c20d-us/Gnimu/branding/wordmark/gnimu-wordmark-white-on-navy.png

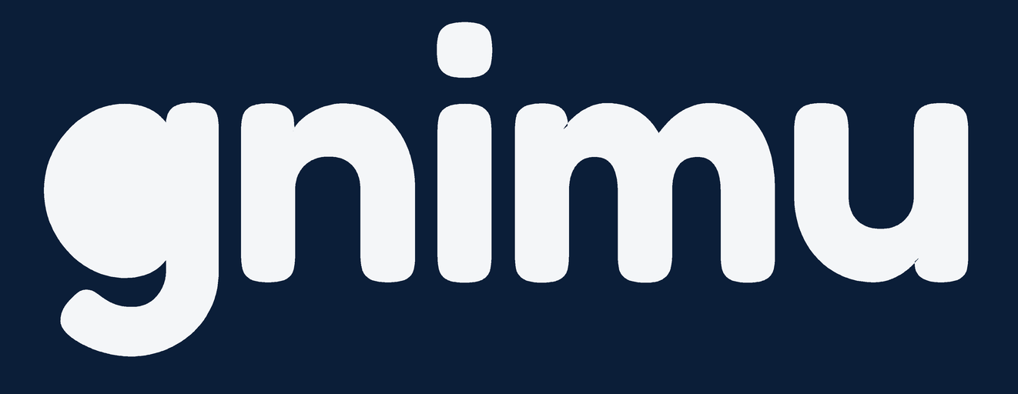
branding/wordmark/gnimu-wordmark-white-on-navy.png
