c20d-us/Gnimu/docs/building.md

# Building and flashing

The firmware is one Arduino sketch, [`code/Gnimu/`](../code/Gnimu/), that builds for both supported boards. You can build it in the Arduino IDE or from the command line with `arduino-cli`; both use the same toolchain and produce the same firmware.

For the hardware side of a build (parts, wiring, photos), see the guide for your board: [ESP32](build-esp32.md) or [XIAO nRF52840](build-nrf52840.md).

---

## What you need

| | ESP32 | XIAO nRF52840 |
|---|---|---|
| Board package | **esp32** by Espressif Systems | **Seeed nRF52 Boards** |
| Board to select | **ESP32 Dev Module** | **Seeed XIAO nRF52840 Sense** |
| Libraries | SparkFun u-blox GNSS v3 | SparkFun u-blox GNSS v3, Seeed Arduino LSM6DS3 |

BLE support comes with each board package; there is no BLE library to install.

These are the versions the firmware is built and tested against. Newer ones will probably work, but if something breaks after an update, come back to these:

| Component | Version |
|---|---|
| esp32 board package | 3.3.12 |
| Seeed nRF52 Boards | 1.1.13 |
| SparkFun u-blox GNSS v3 | 3.1.15 |
| Seeed Arduino LSM6DS3 | 2.0.7 |

> [!IMPORTANT]
> **Use "Seeed nRF52 Boards", not "Seeed nRF52 mbed-enabled Boards".** The mbed-enabled package lacks the Bluefruit BLE stack this firmware uses.

---

## Arduino IDE

1. Install the [Arduino IDE](https://www.arduino.cc/en/software) (2.x).
2. For the XIAO nRF52840, add this URL under **Settings → Additional boards manager URLs**:
   ```
   https://files.seeedstudio.com/arduino/package_seeeduino_boards_index.json
   ```
3. Install the board package for your board from the **Boards Manager**, and the libraries from the **Library Manager** (see the table above).
4. Open [`code/Gnimu/Gnimu.ino`](../code/Gnimu/Gnimu.ino).
5. Select your board and its serial port.
6. Click **Upload**.
7. Open the **Serial Monitor** at **115200 baud** to watch the boot log. See [Console and diagnostics](console.md) for what it shows.

There is nothing you have to edit before the first build. The settings you might want to change later are in [`Config.h`](../code/Gnimu/Config.h), which appears as a tab next to the sketch; see [Configuration](configuration.md).

If an upload to the XIAO can't reset the board into its bootloader, **double-tap the reset button on the XIAO** to force it, then upload again.

> [!IMPORTANT]
> If you are building on an Apple Silicon Mac, you can use the native Arduino IDE but you **must** have Rosetta installed in order to compile. Without Rosetta installed you will get a compilation error.

> [!IMPORTANT]
> **macOS build gotcha (XIAO nRF52840):** The Seeed nRF52 core's `platform.txt` invokes bare `python` for its UF2 step, but modern macOS only ships `python3`, so compiling fails with `exec: "python": executable file not found in $PATH`.
>
> **Fix:** with Homebrew's Python installed (`brew install python`), put its unversioned `python` on your `PATH` by adding this line to your zsh startup file, such as `~/.zshrc`:
> ```bash
> export PATH="$(brew --prefix python)/libexec/bin:$PATH"
> ```
> Editing the core's `platform.txt` also works, but the edit reverts on every core reinstall or update. [`scripts/setup.sh`](../scripts/setup.sh) checks that `python` resolves.

### The build stamp

Every boot prints a `BUILD` line with the firmware's version, git revision, and build time. Those values are filled in by the build script described below, and reach a device when it is [flashed from the command line](#flashing-from-the-command-line). The Arduino IDE doesn't run that script, so an IDE build reports placeholders instead:

```
BUILD,version=0.0.0-dev,revision=IDE-UNSTAMPED,dirty=unknown,utc=unknown,target=...
```

That is expected, and the firmware is otherwise identical.

---

## Command line

[`scripts/build.sh`](../scripts/build.sh) builds the firmware with `arduino-cli`:

```bash
scripts/build.sh            # both boards
scripts/build.sh esp32      # one board
scripts/build.sh nrf52840
scripts/build.sh nrf52840 --hardware classic   # Classic nRF52840 wiring and IMU axes
scripts/build.sh --matrix                      # every board and profile combination
```

`--hardware <name>` and `--protocol <name>` choose the build's [profiles](configuration.md#build-variants): small header files that hold the pins, the IMU mounting and the protocol. Hardware profiles belong to a board, so name the board with `--hardware`. Left out, the build uses the defaults. The choice is passed to the compiler as a flag, so no file is modified, and a build from a clean tagged commit reports `dirty=0` whichever profile you pick.

The script:

- compiles from clean with all warnings on, and **fails if any warning comes from the project's own sources** (warnings from board packages and libraries are shown but don't fail the build);
- stamps the version, git revision, and build time into the firmware;
- writes the finished firmware to `build/esp32/` or `build/nrf52840/`, with the profile names appended when you give them (`build/nrf52840-classic/`), so builds of one commit don't overwrite each other.

It finds `arduino-cli` on your `PATH`, or uses the copy bundled with the Arduino IDE on macOS, or whatever `ARDUINO_CLI` points to. It uses its own build folder, so it can run alongside an IDE build without either disturbing the other.

### Setting up a fresh machine

On a clean Mac, with no Arduino IDE:

```bash
xcode-select --install                                  # git, g++, python3
softwareupdate --install-rosetta --agree-to-license     # Apple Silicon only
brew install arduino-cli python
```

Add the `python` line from the [macOS build gotcha](#arduino-ide) to your zsh startup file (such as `~/.zshrc`), then run:

```bash
scripts/setup.sh
```

[`scripts/setup.sh`](../scripts/setup.sh) checks those tools, then installs the board packages and libraries at the tested versions. It is safe to run again. [`arduino-cli.yaml`](../arduino-cli.yaml), in the repository root, carries the Seeed boards manager URL. If you already installed everything through the Arduino IDE, `arduino-cli` shares those installs and there is nothing more to do.

### Flashing from the command line

[`scripts/flash.sh`](../scripts/flash.sh) uploads what `build.sh` last built for a board. It doesn't build anything itself, so what reaches the device is exactly the firmware in `build/<board>/`, stamp included.

```bash
scripts/build.sh nrf52840
scripts/flash.sh nrf52840
```

`flash.sh` takes the same `--hardware` and `--protocol` options as `build.sh` and picks the matching build directory, so pass the ones you built with. Add `--build` to build first with those options and flash the result in one step; if the build fails, nothing is flashed:

```bash
scripts/flash.sh nrf52840 --build --hardware classic
```

Add `--monitor` to open the serial console on the same port once the upload finishes, so you see the [boot log](console.md#the-boot-log) from the first line. Press Ctrl-C to quit:

```bash
scripts/flash.sh nrf52840 --monitor
```

**XIAO nRF52840.** With one XIAO connected, the script finds its port by itself. The upload resets the board into its bootloader, as it does from the IDE; if that fails, double-tap the XIAO's reset button and run the script again.

**ESP32.** A dev board's USB-serial chip doesn't say what board it's on, so name the port:

```bash
scripts/build.sh esp32
scripts/flash.sh esp32 /dev/cu.usbserial-0001
```

To see which ports are connected:

```bash
arduino-cli board list
```

On macOS they look like `/dev/cu.usbmodem1101` or `/dev/cu.usbserial-0001`; on Linux, `/dev/ttyACM0` or `/dev/ttyUSB0`; on Windows, `COM3`.

Close the IDE's Serial Monitor, or any other serial terminal on that port, before flashing. An open terminal can block the upload.

A device flashed this way reports a stamped `BUILD` line, at boot and whenever you type `V`:

```
BUILD,version=2.0.0-rc1,revision=7f7efe5f4d6a,dirty=0,utc=2026-10-11T17:27:43Z,target=esp32
```

| Field | Meaning |
|---|---|
| `version` | The tag the firmware was built from. Between tags it is the nearest tag, the number of commits since it, and the commit, such as `2.0.0-rc1-3-g1a2b3c4`. |
| `revision` | The commit the firmware was built from. |
| `dirty` | `1` if the working tree had uncommitted changes when it was built, `0` if it was clean. |
| `utc` | When it was built. |

That line settles which firmware a device is running, which an IDE build's `IDE-UNSTAMPED` cannot. Which hardware profile and protocol it was built for follow in the `Config:` lines `V` prints (`hardware`, `IMU axes`, `BLE`).

The script is a thin wrapper. The command underneath is:

```bash
arduino-cli upload --config-file arduino-cli.yaml --fqbn <board> --port <port> --input-dir build/<board>
```

with `esp32:esp32:esp32` or `Seeeduino:nrf52:xiaonRF52840Sense` as the board.

---

## Host tests

The hardware-independent part of the firmware, [`code/Gnimu/src/core/`](../code/Gnimu/src/core/), has unit tests that run on your computer with no board attached:

```bash
tests/run.sh
```

It needs only `g++`. Each test is built and run twice: once plain, and once under AddressSanitizer and UndefinedBehaviorSanitizer, where the first finding fails the run.

The tests compile as C++11 on purpose. The Seeed nRF52 board package builds sketches as C++11, so anything newer in `core/` would fail the nRF52840 build; compiling the tests the same way catches it here first.

---

## Continuous integration

Every push and pull request runs the host tests and builds both boards with `scripts/build.sh`, at the versions listed above. The workflow is [`.github/workflows/ci.yml`](../.github/workflows/ci.yml).
