c20d-us/Gnimu/classic/src/Gnimu-nRF52840-OLED/config.h

// Gnimu - RaceBox Mini-compatible GNSS+IMU streaming telemetry
// Copyright (C) 2026 Chris Halstead
//
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
#pragma once

// This file has two top-level sections:
//   1. TUNABLES - values you should expect to change: thresholds, timing,
//      alphas, feature flags, per-build calibration, and wiring choices you
//      made yourself (i.e., which GPIO you routed a signal to).
//   2. SUPPORTING CONSTANTS - hardware descriptors that will break the
//      firmware if changed without also changing the physical part: pins/
//      addresses fixed by the board or chip, protocol UUIDs, and values
//      derived from other constants.
// Within each section, entries are grouped by subsystem (Device Identity,
// SAADC, IMU, GNSS, BLE, Battery, Power, State, LED, Logging, Protocol), in
// the same order in both sections. Every define is prefixed with the
// subsystem it belongs to, and every value that carries a unit is suffixed
// with it (_MS, _US, _MV, _V, _HZ, _G, _DPS, _DEG, _DBM, _OHM, _BITS, _PIN).

// Pull in Arduino.h for the board's pin/peripheral macros (D6, D7,
// PIN_LSM6DS3TR_C_POWER, ...). config.h uses these symbolic names instead of
// raw pin numbers, so it must see Arduino.h first.
#include <Arduino.h>

// ============================================================================
// ============================================================================
// SECTION 1: TUNABLES
// ============================================================================
// ============================================================================

// ----------------------------------------------------------------------------
// --- Device Identity ---
// ----------------------------------------------------------------------------

// Change DEVICE_ID to personalize your device.
// It is a STRING of exactly 10 digits - quote it, so leading zeros are kept
// (e.g. "0123456789"). Do NOT use a bare number: a leading zero would be read
// as an octal literal and an unquoted ID loses its leading zeros.
// First digit must be 0-3, so the value stays below 4000000000 - the RaceBox
// app will not connect to IDs of 4000000000 or higher. See compile-time
// validation at the bottom of this file.
#define DEVICE_ID "1000000003"

// Identifies which build this binary is, printed as the first line of the
// startup banner. Purely diagnostic - nothing branches on it.
#define GNIMU_VARIANT "nRF52840-OLED"

// ----------------------------------------------------------------------------
// --- IMU (onboard LSM6DS3TR-C) ---
// ----------------------------------------------------------------------------

#define IMU_SAMPLE_INTERVAL_MS 10 // default 100Hz filter/sample rate

// ImuAxis smoothing rates and transient thresholds. The deviation that a
// sample window's peak must exceed before it gets blended into the transmitted
// value instead of the plain EMA baseline.
//
// The ACCEL values are tuned from 13 autocross runs (2018 M2, RE-71RS) checked
// against the GNSS solution: longitudinal against d(speed)/dt, lateral against
// v * yaw-rate. The GYRO values are still placeholders - the logging app
// records no gyro channel, so nothing here has been tested against real data.
//
// The threshold must sit ABOVE the car's vibration floor. At the original 0.2g
// it sat below it: the blend fired on 50-100% of transmit windows, and since
// maxDeviation_ is a max over the window it can only push the output away from
// the baseline, never toward it. Logged lateral peaks ran up to +105% over the
// true value (2.57g against a real 1.16g) and correlation with the GNSS
// reference fell to 0.92.
//
// 1.5g is a HOLDING value for a mount known to be too springy, where the
// vibration floor alone drives |raw - smoothedValue_| to ~1.55g. No threshold
// below that separates vibration from genuine events, so the blend is
// deliberately parked out of reach and the output is the plain EMA baseline.
// Re-tune after the mount is stiffened: log the real floor, then set this to
// roughly 1.2x the observed peak deviation (~0.6-0.8g on a rigid mount) to
// bring the blend back for the impacts and kerb strikes it exists to catch.
//
// The two settings are NOT independent. A lower alpha makes the EMA baseline
// lag further, which INCREASES |raw - smoothedValue_| and so makes the blend
// fire MORE. Lowering the alpha without raising the threshold first makes the
// output worse, not smoother.
//
// The alpha also serves as the anti-alias filter for the 100Hz -> transmit-rate
// decimation, so it cannot be raised freely: mount resonance above the
// transmit Nyquist folds into the signal band, where no later filter can
// remove it. 0.09 puts the corner at ~1.5Hz, which measured best against the
// GNSS reference (0.99 correlation) while leaving real cornering amplitude
// intact - below ~0.06 it starts eating genuine signal.
#define IMU_ACCEL_ALPHA 0.09f // EMA smoothing: 1.0=raw, 0.1=heavy. ~1.5Hz
#define IMU_GYRO_ALPHA 0.09f  // EMA smoothing: 1.0=raw, 0.1=heavy. ~3.6Hz
#define IMU_ACCEL_TRANSIENT_THRESHOLD_G 99.0f    // 1.5g = ~14.7m/s^2
#define IMU_GYRO_TRANSIENT_THRESHOLD_DPS 9999.0f // 28.6deg/s = ~0.5rad/s

#define IMU_ACCEL_RANGE_G 4       // +/- g sensor range: one of 2, 4, 8, 16
#define IMU_GYRO_RANGE_DPS 500    // deg/s sensor range: 125,245,500,1000,2000
#define IMU_ACCEL_ODR_HZ 104      // output data rate; >= the 100Hz poll rate
#define IMU_GYRO_ODR_HZ 104       // output data rate; >= the 100Hz poll rate
#define IMU_ACCEL_BANDWIDTH_HZ 50 // anti-alias filter: one of 50, 100, 200, 400

// --- Runtime IMU trim (levelling + gyro de-bias) ---
// Learned while the vehicle is confirmed stationary, frozen while it moves.
// Corrects a slightly off-level mount and the gyro zero point without any
// per-board calibration step. Design record: docs/imu-trim-design.md.
//
// These are per-DESIGN values, not per-board: identical on every unit. Only
// IMU_GRAVITY_NATIVE and IMU_TRIM_GYRO_VAR_MAX differ between the nRF52840
// and ESP32 families, and only because their native units differ.

// 1 g expressed in this variant's native accel units. The trim module is
// otherwise unit-agnostic; this is the single magnitude it needs.
#define IMU_GRAVITY_NATIVE 1.0f // g on the LSM6DS3; 9.80665f (m/s^2) on ESP32

// How long every stillness criterion must hold CONTINUOUSLY before a window
// opens.
//
// Sensor noise is NOT what sets this: at ~90ug/sqrt(Hz) and 50Hz bandwidth,
// half a second of averaging lands under 0.1mg, two orders finer than anything
// relevant.
//
// Nor is it what keeps a sloped staging lane out of the calibration - locking
// after the first qualifying window does that, because the first stop of a
// session is the paddock. Selection happens by ORDERING, not by duration.
//
// What the length actually buys is a backstop for when that ordering does not
// hold: the device is switched on as the car leaves the paddock, so the first
// qualifying stop is a staging lane or a red light on a cambered road. 10s
// clears a rolling pause or a stop sign. It cannot fix the case properly -
// only powering the device on where it is parked does that.
#define IMU_TRIM_QUALIFY_MS 10000

// Averaging block length once the window is open. A long stop yields a steady
// run of blocks rather than re-serving the qualification delay between each.
#define IMU_TRIM_BLOCK_MS 1000

// Blocks averaged into the orientation before it LOCKS for the rest of the
// power cycle. 5 blocks = 5s of data on top of the qualification wait.
//
// Not a noise requirement - the gate already rejects any block containing a
// disturbance, and one block is far more than enough for precision. This is
// margin against a sub-threshold disturbance (someone leaning on the car)
// biasing a measurement that is never revisited.
#define IMU_TRIM_LOCK_BLOCKS 5

// GNSS ground speed below which we may be stationary.
#define IMU_TRIM_SPEED_MAX_MPS 0.5f

// |a| PLAUSIBILITY band, as a fraction of gravity - unit-free, hence no
// per-variant value.
//
// Deliberately WIDE, and deliberately not a tight "is |a| exactly 1 g" test.
// A tight band has the same circularity that made us gate the gyro on variance
// rather than magnitude: |a| at rest is contaminated by the chip's own zero-g
// bias, which is exactly what the trim exists to remove, so a tight band holds
// the gate shut against the very measurement that would fix it.
//
// That is not hypothetical. The MPU-6050 on the ESP32 build has -69 mg on Z;
// once its hand-measured offset was deleted it read 0.925 g at rest, failed a
// 4% band on every single sample, and could never converge (2026-09-09).
//
// This band's only job is catching something gross - a misconfigured
// IMU_GRAVITY_NATIVE (wrong by ~9.8x), a dead axis, a failed read. Motion is
// caught by IMU_TRIM_ACCEL_VAR_MAX and the GNSS speed gate, not by this.
#define IMU_TRIM_ACCEL_SANITY_TOL 0.25f

// Per-axis accel STANDARD DEVIATION ceiling, in native units - the real
// stillness test for the accelerometer, and bias-immune by construction in the
// same way the gyro's is.
//
// Measured: stationary engine-idling in a 2018 M2 gives per-axis sd of 6-10 mg;
// driving gives 70-118 mg. This sits ~4x above idle and ~2x below driving, and
// it is the secondary check anyway - GNSS speed is the primary motion gate.
#define IMU_TRIM_ACCEL_VAR_MAX 0.04f // g

// Per-axis gyro STANDARD DEVIATION ceiling, in native units. Variance, not
// magnitude: gating on |gyro| would be circular, since a chip whose resting
// bias exceeds the threshold would hold the gate shut against the very
// measurement that would correct it (one board here sits at -4 deg/s).
//
// MEASURED, not guessed. Raw stationary capture in a 2018 M2 (2026-09-08):
// cold idle 0.62 deg/s, warm idle 0.37 deg/s, driving 3.6-4.2 deg/s. The
// original 0.5 blocked a cold idle entirely - trim would never converge if the
// logger was switched on after starting the car, which is the natural order.
// 1.0 clears cold idle by 1.6x and still sits 4.2x under driving.
//
// Allowing an idling engine is safe, and that was checked rather than assumed:
// simulating the real 5-block capture on that data gives 0.019 deg
// repeatability at cold idle and 0.019 deg at warm idle - identical despite
// 68% more vibration, because the block mean removes a zero-mean signal.
// Against 3.2 deg of ground-slope difference measured between two ordinary
// parking spots, vibration is ~150x down and simply not in the error budget.
//
// n=1 vehicle, and a reasonably smooth six. A four-cylinder or a diesel could
// sit well above this; if trim will not converge in a rougher car, start here.
#define IMU_TRIM_GYRO_VAR_MAX 1.0f // deg/s; ~0.01745f rad/s on ESP32

// Largest tilt this module will correct. Beyond it the rotation is REFUSED
// rather than clamped and imuTrimConverged() stays false, but the measured
// angle is still reported so a mounting guard can see it. Past ~15 degrees the
// user has most likely made a mistake rather than a choice.
#define IMU_TRIM_MAX_TILT_DEG 15.0f

// Demand a valid 3D GNSS fix before trimming at all. Closes the hole in
// the gate: constant-velocity cruise on smooth pavement reads ~1g magnitude
// with near-zero gyro variance and is otherwise indistinguishable from parked.
// The cold-start window this costs is not scarce - powering on parked gives
// minutes of stillness after first fix. SET TO 0 FOR BENCH TESTING, which
// never gets a fix indoors.
#define IMU_TRIM_REQUIRE_FIX 1

// How long the last PVT epoch may go without advancing before its speed stops
// counting as valid. gnssLatestPvt() returns the last epoch however stale, so
// a receiver that dies mid-drive would otherwise freeze at a stale 0 m/s and
// let the gate pass while moving.
#define IMU_TRIM_PVT_STALE_MS 1000

// --- Axis orientation (installed mounting) ---
// Corrects the sensor's raw axes into the vehicle frame.
// The bench-verified orientation of the XIAO Sense:
//      +X -> toward the BLE-antenna end (away from USB-C)
//      +Y -> toward the left edge (LED side)
//      +Z -> up, out of the top of the SoC face
// What may vary per BUILD is how the module sits in your enclosure. Each
// VEHICLE axis below names which SENSOR axis feeds it (0=X, 1=Y, 2=Z) plus a
// sign. This covers all 24 physically-realizable orientations.
//
// TARGET OUTPUT FRAME: X forward+, Y left+, Z up+ (ISO 8855, right-handed).
//
// ORDER NAMES read as "which sensor axis feeds vehicle X, Y, Z". Because the
// target frame is right-handed, a valid map is always a proper rotation, so
// the permutation's parity must match the number of sign flips - odd needs
// odd, even needs even. The static_assert at the bottom of this file enforces
// it; a map that fails is a mirror, which no physical mounting can produce.
//
//   Order   _SRC triple   Parity   Sign flips required
//   XYZ     0, 1, 2       even     even (0 or 2)
//   XZY     0, 2, 1       odd      odd  (1 or 3)
//   YXZ     1, 0, 2       odd      odd  (1 or 3)
//   YZX     1, 2, 0       even     even (0 or 2)
//   ZXY     2, 0, 1       even     even (0 or 2)
//   ZYX     2, 1, 0       odd      odd  (1 or 3)
//
// TO DERIVE A NEW MAP, no drive test is needed - hold the assembled unit in
// its installed orientation and read the 1 Hz serial milliG line:
//   1. At rest, the axis reading ~+/-1000 is vehicle-vertical; sign gives
//      up vs down.
//   2. Raise the forward end - the axis going positive is vehicle X.
//   3. Raise the left side  - the axis going positive is vehicle Y.
#define IMU_AXIS_X_SRC 0 // vehicle forward <- sensor X
#define IMU_AXIS_X_SIGN +1.0f
#define IMU_AXIS_Y_SRC 1 // vehicle left    <- sensor Y
#define IMU_AXIS_Y_SIGN +1.0f
#define IMU_AXIS_Z_SRC 2 // vehicle up      <- sensor Z
#define IMU_AXIS_Z_SIGN +1.0f

// --- LIGHT_SLEEP wake-up detector (omni-directional shake-to-wake) ---
// Configured via direct register writes (the Seeed library has no high-level
// API for this) per ST AN4650. A low ODR is what puts the accelerometer into
// the chip's automatic low-power mode; full accuracy isn't needed just to
// detect "something moved." FS is deliberately kept matched to
// IMU_ACCEL_RANGE_G (the RUNNING-mode range) rather than dropped to +/-2g:
// since this is a live mode switch on an already-running chip (not a cold
// power-on), changing FS_XL creates a scale discontinuity in the wake-up
// detector's raw-code threshold comparison that persists (not a settling
// transient - a delay before arming does not fix it) and reliably
// false-triggers immediately. Only ODR changes across the RUNNING<->LIGHT_SLEEP
// transition now.
#define IMU_WAKE_CTRL1_XL 0x18
// 6-bit wake-up threshold (0-63), LSB weight = FS_XL/64 - so this scales with
// the FS_XL chosen above; re-tune with src/tools/nRF52840/imu_wake if FS_XL
// changes. THE key tunable for shake-to-wake: too low false-triggers on small
// vibrations, too high misses a real pickup.
#define IMU_WAKE_THS 4
#define IMU_WAKE_DUR 0 // debounce, in ODR cycles - 0 = fire on first sample

// ----------------------------------------------------------------------------
// --- GNSS (HGLRC M100 Mini, u-blox M10 chipset) ---
// ----------------------------------------------------------------------------

// --- GNSS power gate pin (TPS63020 buck-boost EN) ---
// Drives the regulator EN pad that powers the GNSS 3.3V rail. Wire this to
// whichever GPIO you use for the gate on your build. Must be set with
// pinMode(OUTPUT) before any digitalWrite. An INPUT-mode pin lets the TPS
// pullup silently win every write, defeating our rail-cutoff.
#define GNSS_EN_PIN D9

// No need for greater than 115200; higher can reduce PVT rate.
#define GNSS_BAUD 115200
#define GNSS_NAV_RATE_HZ 20   // 20 is max for 2 enabled constellations
#define GNSS_SV_MINELEV_DEG 5 // ignore SVs below this angle (anti-multipath)
#define GNSS_DYNAMIC_MODEL DYN_MODEL_AUTOMOTIVE

// --- LIGHT_SLEEP wake pulse ---
// gnssWake() rouses the receiver from RXM-PMREQ backup mode by releasing
// Serial1 and driving GNSS_TX_PIN through a manual LOW->HIGH->LOW pulse.
#define GNSS_WAKE_PULSE_MS 10

// --- GNSS Constellation Toggles ---
// Enable only the constellations your module supports and your region benefits
// from. Enabling too many can reduce the PVT rate.
// For 20Hz PVT rate, enable up to 2 constellaations.
// For 25Hz PVT rate, enable only 1 constellation.
// For North American use you should always include GPS.
// Reference: https://app.qzss.go.jp/GNSSView/gnssview.html
#define GNSS_CONSTELLATIONS                                                    \
  {                                                                            \
      {"GPS", SFE_UBLOX_GNSS_ID_GPS, true},                                    \
      {"Galileo", SFE_UBLOX_GNSS_ID_GALILEO, true},                            \
      {"GLONASS", SFE_UBLOX_GNSS_ID_GLONASS, false},                           \
      {"BeiDou", SFE_UBLOX_GNSS_ID_BEIDOU, false},                             \
      {"QZSS", SFE_UBLOX_GNSS_ID_QZSS, false},                                 \
      {"SBAS", SFE_UBLOX_GNSS_ID_SBAS, false},                                 \
  }

// ----------------------------------------------------------------------------
// --- BLE (Bluefruit) ---
// ----------------------------------------------------------------------------

// BLE Transmit Power in dBm.
// Two independent levels: the power used while ADVERTISING (idle/discoverable)
// and the power used once a client is CONNECTED. Lower power reduces RF
// interference with the GNSS.
// Valid nRF52840 levels: -40, -20, -16, -12, -8, -4, 0, 2, 3, 4, 5, 6, 7, 8.
#define BLE_TX_POWER_ADV_DBM -12  // while advertising
#define BLE_TX_POWER_CONN_DBM -12 // while client is connected

// ----------------------------------------------------------------------------
// --- Battery ---
// ----------------------------------------------------------------------------

// --- Low-voltage cutoff ---
// On a sustained VBAT drop below the cutoff voltage, the firmware kills the
// GNSS rail (EN pulled low) then enters System OFF, which remains latched until
// a real power event (USB plug-in or a switch off->on cycle).
// Debounce so acquisition current spikes don't trip it.
#define BATTERY_CUTOFF_V 3.30f          // Cutoff voltage threshold
#define BATTERY_WARN_V 3.40f            // Amber LED blink voltage threshold
#define BATTERY_CRITICAL_V 3.35f        // Red LED blink voltage threshold
#define BATTERY_CUTOFF_DEBOUNCE_MS 5000 // low-V duration before tripping

// --- Non-blocking VBAT sampler ---
// The sampler advances an IDLE/SAMPLING state machine from batteryPoll().
// Every BATTERY_POLL_INTERVAL_MS it collects BATTERY_SAMPLE_COUNT paced ADC
// reads (~BATTERY_SAMPLE_SPACING_US between reads -> ~50ms observation
// window at defaults), tracks min/max, and terminates on count. Peak feeds
// both SoC and the low-voltage cutoff (peak rejects load-sag transients that
// lie about the resting voltage). At 4Hz cadence a ~5s cutoff debounce
// sees ~20 runs of evidence before tripping.
#define BATTERY_POLL_INTERVAL_MS 250   // 4Hz between sampling-run starts
#define BATTERY_SAMPLE_COUNT 20        // paced ADC reads per run
#define BATTERY_SAMPLE_SPACING_US 2500 // paced sample spacing (~50ms window)

// --- Charge-full indication (LED only) ---
// The XIAO exposes no charge-complete signal from its charger IC, so "fully
// charged" is approximated from voltage: while charging (USB present), a cell
// voltage at or above BATTERY_FULL_V shows as full (solid green LED) vs.
// blinking green while still charging.
//
// Deliberately set BELOW the 4.2V CV target, and NOT equal to the discharge
// curve's "4.20V = 100%" point, which is a *resting* voltage, a different
// thing. During charge the charger holds ~4.2V with its own tolerance, and
// the VBAT divider/ADC add theirs, so a 4.2V threshold might never be
// reached and "full" would never latch. A small margin guarantees it triggers
// near the top.
#define BATTERY_FULL_V 4.15f

// --- Fast charge ---
// Define to select the ~100mA charge pad on the XIAO(default ~50mA).
// Comment out to leave the board at its default charge current.
#define BATTERY_FAST_CHARGE

// EMA factor across sampler runs for the DISPLAYED voltage (percent/LED):
// higher = snappier, lower = smoother. The low-voltage cutoff uses the
// un-smoothed fresh peak, so this is display-only and can never hide a
// genuine low voltage cutoff from the safety path.
#define BATTERY_EMA_ALPHA 0.1f

// --- Discharge curve (resting volts -> percent), high to low ---
// A macro (not an array) so the table lives here while g_battery.cpp owns
// the single instance: it expands to an initializer list of
// {voltage, percent} pairs. Must be sorted high voltage -> low.
//
// Deliberately simplified to just two endpoints - a straight line, not a
// real LiPo discharge curve.
#define BATTERY_DISCHARGE_CURVE {{4.10f, 100}, {3.30f, 0}}

// ----------------------------------------------------------------------------
// --- Power ---
// ----------------------------------------------------------------------------

// --- Slide-switch sense via voltage divider ---
// The 2-position, 3-pole slide switch's spare throw is wired through a
// 510k/510k resistor divider to A1: reads ~2V (of the ~4.2V node) when the
// switch is OFF and ~0V when ON. This gives a load-independent, SoC-
// independent battery-present signal. Read as ANALOG (via ADC), not digital.
// Divider sized at 510k for low always-on switch-off standby draw (~4uA), while
// staying inside the SAADC's TACQ=40us source-impedance budget and the GPIO
// input-leakage margin below POWER_SWITCH_OFF_THRESHOLD_MV.
#define POWER_SWITCH_SENSE_PIN A1         // Set to your selected GPIO pin
#define POWER_SWITCH_OFF_THRESHOLD_MV 800 // pin mv above this == switch OFF

// How often powerSwitchOn() refreshes its cached switch-sense reading. Reads
// between refreshes return the cache, keeping the per-loop cost to a compare.
#define POWER_SWITCH_POLL_INTERVAL_MS 50

// ----------------------------------------------------------------------------
// --- State ---
// ----------------------------------------------------------------------------

// When 1, plugging in USB with the switch ON auto-enters CHARGE_ONLY (all
// peripherals held off, LiPo cell in circuit for max charge speed). Exit is
// unplug USB or switch off, both of which reset the MCU back through the
// boot classifier.
// When 0, USB presence is ignored and the device stays in RUNNING while plugged
// in. Use this mode for bench development so a plugged-in device continues
// streaming/serving BLE.
#define STATE_CHARGE_ONLY_ON_USB 0

// --- LIGHT_SLEEP timing (Phase 2) ---
// Defensive power-shedding for a device left running with no BLE client
// connected. Three tiers, all measured from last BLE disconnect in RUNNING:
//   1. STATE_IDLE_TIMEOUT_MIN (RUNNING -> LIGHT_SLEEP). GNSS drops to
//      backup mode (ephemeris retained, wakes in ~1-3s), IMU arms its
//      wake-up detector, LED blinks blue slowly. Reversible without a reset.
//      BLE client connect or IMU shake-to-wake returns to RUNNING instantly.
//   2. STATE_LIGHT_SLEEP_GNSS_CUTOFF_MIN (from LIGHT_SLEEP entry). GNSS
//      power save escalates to a full EN-cut. By this point ephemeris would
//      likely be stale anyway, so there's no reacquisition-speed cost to
//      cutting harder. BLE/IMU wake capability is unaffected.
//   3. STATE_LIGHT_SLEEP_TIMEOUT_MIN (from LIGHT_SLEEP entry).Gives up
//      entirely and drops to DEEP_SLEEP (System OFF). This is the ultimate
//      backstop for a truly-forgotten device. Past this point BLE/shake-to-wake
//      no longer work. Recovery requires a switch cycle or USB plug-in,
//      same as any other DEEP_SLEEP entry.
#define STATE_IDLE_TIMEOUT_MIN 30
#define STATE_LIGHT_SLEEP_GNSS_CUTOFF_MIN 180
#define STATE_LIGHT_SLEEP_TIMEOUT_MIN 360

// --- Switch-off debounce ---
// A floating/unwired switch-sense pin, and even a wired divider under EMI,
// can produce transient OFF readings; require the OFF to be sustained this
// long before entering BATTERY_WAIT so a noise spike can't reset a
// happily-running device. Switch-ON is instant.
#define STATE_SWITCH_OFF_DEBOUNCE_MS 500

// ----------------------------------------------------------------------------
// --- LED (onboard RGB status LED) ---
// ----------------------------------------------------------------------------

// Whether the onboard RGB LED does anything in this variant.
//
//   0 = FALLBACK ONLY (ship default). The OLED carries strictly richer status,
//       and the enclosure layout puts the LED where it cannot be seen anyway.
//       But displayBegin() disables itself if no panel answers, so without a
//       fallback a loose I2C wire would leave the device with NO user-visible
//       feedback at all - looking dead while streaming perfectly. The LED
//       therefore comes back automatically when, and only when, the display is
//       absent. BATTERY_WAIT is the case that makes this matter: "you left the
//       switch off" is exactly when you need a signal and least likely to have
//       serial attached.
//   1 = ALWAYS ON, alongside the display. For bench work with the board out of
//       the case, where the LED is genuinely convenient.
//
// Note this does not make the device fully dark either way: the XIAO's charge
// LED is wired to the BQ25101 and cannot be driven by firmware.
#define LED_ENABLED 0

#define LED_BLINK_INTERVAL_MS 1000    // standard interval for blinking states
#define LED_BATTERY_WAIT_BLINK_MS 150 // rapid blink for BATTERY_WAIT

// LIGHT_SLEEP blink - short on, long off (a "sleeping" pulse), deliberately
// distinct from the advertising blink's even on/off.
#define LED_LIGHT_SLEEP_BLINK_ON_MS 250
#define LED_LIGHT_SLEEP_BLINK_OFF_MS 5000

// ----------------------------------------------------------------------------
// --- Display (SSD1306 128x64 OLED) ---
// ----------------------------------------------------------------------------

// 1 = normal operation (default). 0 = display fully disabled at COMPILE TIME.
// This is here as a diagnostic toggle: it isolates whether the display's I2C
// traffic affects the GNSS PVT rate.
//
// displayIsPresent() returns false when this is 0, so LED_ENABLED's fallback
// behavior (g_led lighting up when no display is present) engages
// automatically.
#define DISPLAY_ENABLED 1

// How often the whole screen is re-rendered and pushed. Nothing on screen is
// worth reading faster than this, and every refresh costs I2C time.
#define DISPLAY_REFRESH_INTERVAL_MS 1000 // 1 Hz

// Minimum gap between consecutive slice pushes.
//
// This setting can affect the GNSS rate, and it works on DENSITY rather than
// volume. A whole frame takes ~31ms, but the problem is landing the update
// slices on CONSECUTIVE loop iterations. For the length of a consecutive update
// burst the UART never gets a clear stretch in which to be drained, and NAV-PVT
// bytes get lost. Spacing the pushes leaves roughly four full RX-buffer fill
// windows (~5.5 ms each at GNSS_BAUD) between hits.
//
// This also makes the push duration deterministic: a frame now takes
// (slice count x INTERVAL_MS) milliseconds regardless of how fast loop()
// happens to run, which is what lets the static_assert below check the runaway
// condition at compile time instead of leaving it as a warning in a comment.
#define DISPLAY_SLICE_INTERVAL_MS 20

// Slices pushed in one go immediately after a NAV-PVT has been parsed.
//
// This is the phase-locked path, and it is what actually solved the GNSS rate
// sag on this variant. The receiver's UART is only vulnerable while a message
// is arriving: SERIAL_BUFFER_SIZE on this core is 64 bytes and a NAV-PVT is
// 100, so the MCU must be draining DURING the ~8 ms the message is on the wire
// or bytes are lost mid-message. Outside that there is ~42 ms of clear air at
// 20 Hz in which the MCU can do whatever it likes.
//
// displayUpdate() runs directly after gnssPoll(), so a changed iTOW means the
// message landed moments ago and the clear air is just starting. Pushing a
// small burst there is free; the old DISPLAY_SLICE_INTERVAL_MS metering spread
// pushes evenly instead, which lands them on the arriving message as often as
// not - and does so more as the SV count rises and the receiver's emission
// point drifts later in the period.
//
// Two slices is ~2 ms against that ~42 ms window, and completes a frame in 16
// epochs (0.8 s), inside DISPLAY_REFRESH_INTERVAL_MS. Raise it for a snappier
// frame; the static_assert below stops it eating the window.
#define DISPLAY_SLICES_PER_EPOCH 2

// How long without a new epoch before the display stops waiting for one.
//
// Epochs stop entirely when the receiver is asleep or its rail is cut, and
// CHARGE_ONLY, BATTERY_WAIT and LIGHT_SLEEP all have a screen to draw with no
// NAV-PVT to key off. Past this, displayUpdate() reverts to the
// DISPLAY_SLICE_INTERVAL_MS metering below so the panel keeps updating instead
// of freezing on its last frame. A few epoch periods, generous enough that
// normal jitter never trips it.
#define DISPLAY_EPOCH_STALE_MS 250

// Burn-in pixel shift. The layout is nudged around a 3x3 grid of offsets so no
// element sits on the same pixels for a whole 8-hour run. Slow on purpose: a
// shift dirties the entire frame, and it is visible if it happens often enough
// to notice.
#define DISPLAY_SHIFT_INTERVAL_MS 300000 // 5 minutes

// Bytes pushed per loop() iteration, expressed as tile columns (each tile is
// 8x8 px, so one tile column of one tile row = 8 bytes).
//
// This is a LATENCY control, not a throughput one. A full 1024-byte frame costs
// ~31 ms at 400 kHz. So the frame is rendered into RAM (free) and pushed a
// slice at a time, one slice per loop(). At 8 tiles wide that is 64 bytes,
// roughly 2 ms, and a full frame completes in 16 iterations, which is well
// inside the refresh interval. This value matters, as the the GNSS rate can sag
// to a wandering 15-25 Hz if set too high.
//
// If the rate still wanders, keep halving - but remember each halving doubles
// the iterations per frame, so DISPLAY_REFRESH_INTERVAL_MS has to grow with it
// or the push never finishes before the next one is due.
#define DISPLAY_CHUNK_TILES_W 4

#define DISPLAY_CONTRAST 255 // 0-255; full scale is most readable in daylight

// ----------------------------------------------------------------------------
// --- Logging ---
// ----------------------------------------------------------------------------

// Master switch for all Serial diagnostic output.
// Logging OFF reduced loop latency.
// 1 = normal verbose output
// 0 = silent
#define LOG_ENABLED 1

#define LOG_STATS_INTERVAL_MS 1000 // serial stats reporting interval

// Separate, much slower cadence for LIGHT_SLEEP's own heartbeat (g_state) -
// LOG_STATS_INTERVAL_MS's 1 Hz is right for live telemetry monitoring, but
// LIGHT_SLEEP can last hours (up to STATE_LIGHT_SLEEP_TIMEOUT_MIN), and
// nothing else logs while asleep - without this there's no way to tell it's
// still alive/how long it's been asleep until it wakes back up.
#define LOG_LIGHT_SLEEP_INTERVAL_MS 10000

// ============================================================================
// ============================================================================
// SECTION 2: SUPPORTING CONSTANTS
// These are hardware descriptors or protocol requirements. Changing them
// without also changing the physical part (or the RaceBox protocol) will
// break the firmware.
// ============================================================================
// ============================================================================

// ----------------------------------------------------------------------------
// --- SAADC (shared nRF52840 ADC peripheral) ---
// ----------------------------------------------------------------------------

// nRF ADC config that g_power applies to the shared SAADC (used by both the
// VBAT sampler and the switch-sense read). The internal 3.0V reference
// gives a clean full-scale for a 1S LiPo.
#define SAADC_RESOLUTION_BITS 12
#define SAADC_REFERENCE_MV 3000.0f

// SAADC acquisition time (TACQ), in microseconds. The core default is 3us,
// valid only up to a ~40k source; the XIAO VBAT divider is ~338k (1M || 510k)
// and the switch-sense divider is ~255k (510k || 510k), so short TACQ leaves
// the sampling cap under-charged and every read undershoots ~100mV. 40us
// covers up to ~800k. Value is dictated by the fixed divider impedance, not a
// free performance knob.
#define SAADC_TACQ_US 40

// ----------------------------------------------------------------------------
// --- IMU (onboard LSM6DS3TR-C) ---
// ----------------------------------------------------------------------------

// Powered by a dedicated enable pin; sits on the internal I2C bus (Wire1).
#define IMU_I2C_ADDRESS 0x6A // SA0 tied high on the XIAO Sense

// I2C bus speed for the onboard IMU.
//
// This is a LATENCY setting, not a throughput one. imuPoll() reads six 16-bit
// registers every IMU_SAMPLE_INTERVAL_MS, and the Seeed LSM6DS3 library issues
// each as TWO separate I2C transactions (write register address, then read) -
// twelve transactions per sample tick, no burst read. At the core's default
// bus speed that is the single largest recurring blocking cost in loop(),
// larger than the display's metered slices and 100x/second rather than 32.
//
// The default is NOT 400kHz and has to be set explicitly. TwoWire::begin()
// hardcodes FREQUENCY to K100, and the LSM6DS3 library calls begin() but never
// setClock() - so without this the IMU bus runs at 100kHz while the display's
// runs at 400kHz. g_imu.cpp applies it AFTER myIMU.begin(), which is required:
// begin() resets the frequency register, so setting it earlier is silently
// undone. It is re-applied on every configureNormalMode() for the same reason
// (imuDisarmWake() calls begin() again on each LIGHT_SLEEP exit).
//
// The LSM6DS3TR-C supports I2C fast mode (400kHz) per ST's datasheet, and
// Wire1 is entirely internal to the XIAO - short traces, onboard pull-ups - so
// there is no signal-integrity reason to stay at 100kHz.
#define IMU_I2C_CLOCK_HZ 400000
#define IMU_POWER_PIN PIN_LSM6DS3TR_C_POWER
// Wake-up detector's interrupt output (onboard, no wiring needed).
#define IMU_INT1_PIN PIN_LSM6DS3TR_C_INT1

// Decimate the IMU stream down to the transmission rate. Derived from
// GNSS_NAV_RATE_HZ so the two can't drift out of sync.
#define IMU_TRANSMIT_INTERVAL_MS (1000 / GNSS_NAV_RATE_HZ)

// ----------------------------------------------------------------------------
// --- GNSS (HGLRC M100 Mini, u-blox M10 chipset) ---
// ----------------------------------------------------------------------------

// --- GNSS UART ---
// On the XIAO, Serial1 is D7 (RX) / D6 (TX). The only hardware-UART pins.
// Wiring:
//   XIAO D6 (Serial1 TX) -> GNSS RX
//   XIAO D7 (Serial1 RX) <- GNSS TX
#define GNSS_RX_PIN D7
#define GNSS_TX_PIN D6

// ----------------------------------------------------------------------------
// --- Battery ---
// ----------------------------------------------------------------------------

// This build has a real battery gauge (VBAT sensing + fuel gauge in
// g_battery): the shared telemetry module includes the battery segment in the
// serial stats line. Set to 0 for non-battery builds.
#define BATTERY_HAS_GAUGE 1

// --- Voltage-sense scaling ---
// Recovered VBAT = ADC_volts * (R_TOP + R_BOTTOM) / R_BOTTOM.
// Values are the XIAO nRF52840's onboard divider.
#define BATTERY_DIVIDER_R_TOP_OHM 1000000.0f   // ohms
#define BATTERY_DIVIDER_R_BOTTOM_OHM 510000.0f // ohms
#define BATTERY_DIVIDER_RATIO                                                  \
  ((BATTERY_DIVIDER_R_TOP_OHM + BATTERY_DIVIDER_R_BOTTOM_OHM) /                \
   BATTERY_DIVIDER_R_BOTTOM_OHM)

// --- Battery voltage sense (XIAO internal VBAT divider) ---
// PIN_VBAT / VBAT_ENABLE are normally provided by the variant; fall back to
// the documented Seeed pin numbers if a given core doesn't define them.
// VBAT_ENABLE is driven LOW per-read to connect the divider, then released to
// save power. Confirm these against your installed variant.h.
// Values below are Arduino digital-pin *indices* (what analogRead/digitalWrite
// take), which the variant's g_ADigitalPinMap resolves to the actual nRF port
// pin. Comments note the underlying P0.x pin they land on.
#ifdef PIN_VBAT
#define BATTERY_ADC_PIN PIN_VBAT
#else
#define BATTERY_ADC_PIN 32 // Arduino D32 -> P0.31 / AIN7 (VBAT sense)
#endif
#ifdef VBAT_ENABLE
#define BATTERY_ADC_ENABLE_PIN VBAT_ENABLE
#else
#define BATTERY_ADC_ENABLE_PIN 14 // Arduino D14 -> P0.14 (LOW = divider on)
#endif
// Active-low: driven LOW to connect the divider.

// --- Charge-current select (HICHG pad) ---
// Drive LOW for the ~100mA fast-charge pad, release/HIGH for the ~50mA
// default. See BATTERY_FAST_CHARGE in the Tunables section above.
#ifdef PIN_HICHG
#define BATTERY_CHARGE_CURRENT_PIN PIN_HICHG
#else
#define BATTERY_CHARGE_CURRENT_PIN 22 // Arduino D22 -> P0.13 (HICHG)
#endif

// ----------------------------------------------------------------------------
// --- LED (onboard RGB status LED, active-LOW) ---
// ----------------------------------------------------------------------------

// The XIAO's RGB LED is common-anode: drive a pin LOW to light that color
// (active-low).
#define LED_RED_PIN LED_RED
#define LED_GREEN_PIN LED_GREEN
#define LED_BLUE_PIN LED_BLUE

// ----------------------------------------------------------------------------
// --- Display (SSD1306 128x64 OLED, hardware I2C) ---
// ----------------------------------------------------------------------------

// 7-bit address. NOTE u8g2's setI2CAddress() wants the 8-bit left-shifted form;
// g_display does that shift, so this stays the plain 7-bit address everything
// else in the world quotes.
#define DISPLAY_I2C_ADDRESS 0x3C

// Panel geometry, and the content area the layout is drawn into.
//
// The pixel shift is POSITIVE-ONLY, sliding the layout into a gutter along the
// right and bottom edges.
#define DISPLAY_WIDTH 128
#define DISPLAY_HEIGHT 64
#define DISPLAY_SHIFT_MAX 2
#define DISPLAY_LAYOUT_W (DISPLAY_WIDTH - DISPLAY_SHIFT_MAX)
#define DISPLAY_LAYOUT_H (DISPLAY_HEIGHT - DISPLAY_SHIFT_MAX)

// Tiles are 8x8 px, so the panel is 16x8 tiles.
#define DISPLAY_TILES_W (DISPLAY_WIDTH / 8)
#define DISPLAY_TILES_H (DISPLAY_HEIGHT / 8)

// ----------------------------------------------------------------------------
// --- Protocol (RaceBox BLE protocol) ---
// These match the RaceBox BLE protocol and should not be changed. The UUIDs
// are the Nordic UART UUIDs, which Bluefruit's BLEUart uses natively.
// ----------------------------------------------------------------------------

#define RACEBOX_MODEL "RaceBox Mini"   // Compatibility requirement
#define RACEBOX_MANUFACTURER "RaceBox" // Compatibility requirement
#define RACEBOX_HARDWARE_VERSION "1"   // Compatibility requirement
#define RACEBOX_FIRMWARE_VERSION "3.3" // Compatibility requirement
#define RACEBOX_SERVICE_UUID "6E400001-B5A3-F393-E0A9-E50E24DCCA9E"
#define RACEBOX_CHARACTERISTIC_RX_UUID "6E400002-B5A3-F393-E0A9-E50E24DCCA9E"
#define RACEBOX_CHARACTERISTIC_TX_UUID "6E400003-B5A3-F393-E0A9-E50E24DCCA9E"

// ============================================================================
// --- COMPILE-TIME VALIDATION ---
// ============================================================================

// Enforce device ID format: a 10-digit string with first digit 0-3.
// DEVICE_ID is a string so leading zeros survive; these constexpr helpers let
// us validate that string at compile time (C++ has no compile-time regex).
namespace device_id {
// Length of a C-string literal, counted at compile time.
constexpr int length(const char *s) { return *s ? 1 + length(s + 1) : 0; }
// True only if every character is a digit 0-9.
constexpr bool allDigits(const char *s) {
  return *s == '\0'                 ? true
         : (*s >= '0' && *s <= '9') ? allDigits(s + 1)
                                    : false;
}
} // namespace device_id

static_assert(
    device_id::length(DEVICE_ID) == 10,
    "ERROR: DEVICE_ID must be exactly 10 digits, quoted as a string.");
static_assert(device_id::allDigits(DEVICE_ID),
              "ERROR: DEVICE_ID must contain only digits 0-9.");
static_assert(DEVICE_ID[0] >= '0' && DEVICE_ID[0] <= '3',
              "ERROR: DEVICE_ID's first digit must be 0-3 (value below "
              "4000000000).");

// Validate the three RaceBox protocol UUIDs are well-formed 8-4-4-4-12 hex
// strings, the same way DEVICE_ID's format is checked above.
namespace uuid_format {
constexpr bool isHexDigit(char c) {
  return (c >= '0' && c <= '9') || (c >= 'a' && c <= 'f') ||
         (c >= 'A' && c <= 'F');
}
// Hyphens are required at positions 8, 13, 18, and 23; every other position
// (of the required 36 total) must be a hex digit.
constexpr bool isValid(const char *s, int i = 0) {
  return i == 36 ? s[i] == '\0'
         : (i == 8 || i == 13 || i == 18 || i == 23)
             ? (s[i] == '-' && isValid(s, i + 1))
             : (isHexDigit(s[i]) && isValid(s, i + 1));
}
} // namespace uuid_format

static_assert(uuid_format::isValid(RACEBOX_SERVICE_UUID),
              "ERROR: RACEBOX_SERVICE_UUID must be a standard 8-4-4-4-12 hex "
              "UUID string.");
static_assert(uuid_format::isValid(RACEBOX_CHARACTERISTIC_TX_UUID),
              "ERROR: RACEBOX_CHARACTERISTIC_TX_UUID must be a standard "
              "8-4-4-4-12 hex UUID string.");
static_assert(uuid_format::isValid(RACEBOX_CHARACTERISTIC_RX_UUID),
              "ERROR: RACEBOX_CHARACTERISTIC_RX_UUID must be a standard "
              "8-4-4-4-12 hex UUID string.");

// Enforce GNSS_RX_PIN and GNSS_TX_PIN are distinct pins.
static_assert(GNSS_RX_PIN != GNSS_TX_PIN,
              "ERROR: GNSS_RX_PIN and GNSS_TX_PIN must be different pins.");

// Enforce a GNSS_BAUD the firmware actually knows how to detect and switch
// to. Keep this list in sync with the fallback baud rates in
// connectAndConfigureBaud() (gnss.cpp) - an unswept value here risks telling
// the module to save an unrecoverable baud rate to flash.
static_assert(GNSS_BAUD == 9600 || GNSS_BAUD == 38400 || GNSS_BAUD == 57600 ||
                  GNSS_BAUD == 115200 || GNSS_BAUD == 230400 ||
                  GNSS_BAUD == 460800,
              "ERROR: GNSS_BAUD must be one of the baud rates "
              "connectAndConfigureBaud() knows how to detect/switch between "
              "(9600, 38400, 57600, 115200, 230400, 460800).");

// Enforce navigation rate limit
// A frame is pushed as (DISPLAY_TILES_W / DISPLAY_CHUNK_TILES_W) *
// DISPLAY_TILES_H slices, spaced DISPLAY_SLICE_INTERVAL_MS apart. If that total
// ever exceeds the refresh interval, the next render falls due the instant the
// last one lands and the display pushes CONTINUOUSLY, monopolising the bus and
// undoing the spacing. Each halving of DISPLAY_CHUNK_TILES_W doubles the slice
// count, so this is easy to trip while tuning.
static_assert(((DISPLAY_TILES_W / DISPLAY_CHUNK_TILES_W) * DISPLAY_TILES_H) *
                      DISPLAY_SLICE_INTERVAL_MS <
                  DISPLAY_REFRESH_INTERVAL_MS,
              "ERROR: a full display push takes longer than the refresh "
              "interval - the display would push continuously. Raise "
              "DISPLAY_REFRESH_INTERVAL_MS, or raise DISPLAY_CHUNK_TILES_W, or "
              "lower DISPLAY_SLICE_INTERVAL_MS.");

// --- Phase-locked display push: derived timing ------------------------------
// All of it falls out of GNSS_NAV_RATE_HZ and GNSS_BAUD rather than being
// tuned by hand, so raising the nav rate cannot silently shrink the window the
// display is relying on. At 25 Hz the clear air drops from ~42 ms to ~32 ms.

// Nominal interval between navigation epochs.
#define GNSS_EPOCH_PERIOD_MS (1000 / GNSS_NAV_RATE_HZ)

// Time one UBX-NAV-PVT occupies on the wire: 92-byte payload + 8 bytes of
// frame, at 10 bits per byte for 8N1.
#define GNSS_PVT_WIRE_MS ((100UL * 10UL * 1000UL) / GNSS_BAUD)

// The window in which the MCU may block without costing NAV-PVT bytes.
#define DISPLAY_CLEAR_AIR_MS (GNSS_EPOCH_PERIOD_MS - GNSS_PVT_WIRE_MS)

// Per-slice push cost.
//
// The display bus runs at 400 kHz. Nothing here sets it: u8g2 takes it from the
// SSD1306 descriptor (i2c_bus_clock_100kHz = 4) and applies Wire.setClock() at
// the start of every transfer, which is why the display needed no equivalent of
// the explicit IMU_I2C_CLOCK_HZ call - and why that call targets Wire1 only.
//
// This is still scaled from the MEASURED full-frame figure rather than computed
// from the bus rate, because the measurement includes what the arithmetic
// misses: per-transaction addressing, u8g2's command bytes, and its per-
// transfer setClock(). 1024 bytes at 400 kHz is ~23 ms of pure bus time; ~31 ms
// is what tools/nRF52840-OLED/oled_bench actually reports. Re-run it and update
// this if the panel or bus speed changes.
#define DISPLAY_FRAME_PUSH_MS 31
#define DISPLAY_BUFFER_BYTES ((DISPLAY_WIDTH * DISPLAY_HEIGHT) / 8)
#define DISPLAY_SLICE_BYTES (DISPLAY_CHUNK_TILES_W * 8)
#define DISPLAY_SLICE_PUSH_MS                                                  \
  (((DISPLAY_FRAME_PUSH_MS * DISPLAY_SLICE_BYTES) + DISPLAY_BUFFER_BYTES -     \
    1) /                                                                       \
   DISPLAY_BUFFER_BYTES)

// The burst must fit the clear air with room to spare. This is the guard that
// makes a nav-rate change a build error instead of a field mystery: the whole
// point of pushing after the epoch is that the burst ends before the next
// message starts arriving.
static_assert((DISPLAY_SLICES_PER_EPOCH * DISPLAY_SLICE_PUSH_MS) * 2 <
                  DISPLAY_CLEAR_AIR_MS,
              "ERROR: DISPLAY_SLICES_PER_EPOCH pushes more than half the clear "
              "air between NAV-PVT messages. Lower it, lower "
              "DISPLAY_CHUNK_TILES_W, or lower GNSS_NAV_RATE_HZ.");

// A frame now takes ceil(SLICE_COUNT / DISPLAY_SLICES_PER_EPOCH) epochs. Same
// runaway condition the assert above this section guards for the fallback
// path: if that exceeds the refresh interval the next render is due before the
// last has landed.
#define DISPLAY_FRAME_EPOCHS                                                   \
  (((((DISPLAY_TILES_W / DISPLAY_CHUNK_TILES_W) * DISPLAY_TILES_H)) +          \
    DISPLAY_SLICES_PER_EPOCH - 1) /                                            \
   DISPLAY_SLICES_PER_EPOCH)

static_assert(DISPLAY_FRAME_EPOCHS * GNSS_EPOCH_PERIOD_MS <
                  DISPLAY_REFRESH_INTERVAL_MS,
              "ERROR: a phase-locked frame push takes longer than the refresh "
              "interval. Raise DISPLAY_SLICES_PER_EPOCH or "
              "DISPLAY_REFRESH_INTERVAL_MS, or raise DISPLAY_CHUNK_TILES_W.");

static_assert(GNSS_NAV_RATE_HZ > 0 && GNSS_NAV_RATE_HZ <= 25,
              "ERROR: GNSS_NAV_RATE_HZ must be between 1 and 25.");

// Enforce a sane satellite elevation mask (a real angle above the horizon)
static_assert(GNSS_SV_MINELEV_DEG >= 0 && GNSS_SV_MINELEV_DEG <= 90,
              "ERROR: GNSS_SV_MINELEV_DEG must be between 0 and 90.");

// Enforce sane EMA alpha range
static_assert(IMU_ACCEL_ALPHA > 0.0f && IMU_ACCEL_ALPHA <= 1.0f,
              "ERROR: IMU_ACCEL_ALPHA must be in the range (0.0, 1.0]");
static_assert(IMU_GYRO_ALPHA > 0.0f && IMU_GYRO_ALPHA <= 1.0f,
              "ERROR: IMU_GYRO_ALPHA must be in the range (0.0, 1.0]");

// Enforce positive transient thresholds (a zero/negative threshold would
// disable transient blending entirely; see ImuAxis::read()).
static_assert(IMU_ACCEL_TRANSIENT_THRESHOLD_G > 0.0f,
              "ERROR: IMU_ACCEL_TRANSIENT_THRESHOLD_G must be greater than 0.");
static_assert(
    IMU_GYRO_TRANSIENT_THRESHOLD_DPS > 0.0f,
    "ERROR: IMU_GYRO_TRANSIENT_THRESHOLD_DPS must be greater than 0.");

// Enforce a positive sample interval, and a transmit interval that's at
// least as long as it. Otherwise a transmit window could contain zero fresh
// samples, silently degrading ImuAxis's transient peak tracking to a plain
// EMA with no warning.
static_assert(IMU_SAMPLE_INTERVAL_MS > 0,
              "ERROR: IMU_SAMPLE_INTERVAL_MS must be greater than 0.");
static_assert(IMU_TRANSMIT_INTERVAL_MS >= IMU_SAMPLE_INTERVAL_MS,
              "ERROR: IMU_TRANSMIT_INTERVAL_MS must be >= "
              "IMU_SAMPLE_INTERVAL_MS so each transmit window contains at "
              "least one fast sample for ImuAxis's transient peak tracking "
              "to work.");

// Enforce IMU full-scale ranges are values the LSM6DS3 supports
static_assert(IMU_ACCEL_RANGE_G == 2 || IMU_ACCEL_RANGE_G == 4 ||
                  IMU_ACCEL_RANGE_G == 8 || IMU_ACCEL_RANGE_G == 16,
              "ERROR: IMU_ACCEL_RANGE_G must be one of 2, 4, 8, 16.");
static_assert(
    IMU_GYRO_RANGE_DPS == 125 || IMU_GYRO_RANGE_DPS == 245 ||
        IMU_GYRO_RANGE_DPS == 500 || IMU_GYRO_RANGE_DPS == 1000 ||
        IMU_GYRO_RANGE_DPS == 2000,
    "ERROR: IMU_GYRO_RANGE_DPS must be one of 125, 245, 500, 1000, 2000.");

// Enforce IMU output data rates are values the LSM6DS3 supports
static_assert(IMU_ACCEL_ODR_HZ == 13 || IMU_ACCEL_ODR_HZ == 26 ||
                  IMU_ACCEL_ODR_HZ == 52 || IMU_ACCEL_ODR_HZ == 104 ||
                  IMU_ACCEL_ODR_HZ == 208 || IMU_ACCEL_ODR_HZ == 416 ||
                  IMU_ACCEL_ODR_HZ == 833 || IMU_ACCEL_ODR_HZ == 1666 ||
                  IMU_ACCEL_ODR_HZ == 3332 || IMU_ACCEL_ODR_HZ == 6664,
              "ERROR: IMU_ACCEL_ODR_HZ must be a supported LSM6DS3 rate.");
static_assert(IMU_GYRO_ODR_HZ == 13 || IMU_GYRO_ODR_HZ == 26 ||
                  IMU_GYRO_ODR_HZ == 52 || IMU_GYRO_ODR_HZ == 104 ||
                  IMU_GYRO_ODR_HZ == 208 || IMU_GYRO_ODR_HZ == 416 ||
                  IMU_GYRO_ODR_HZ == 833 || IMU_GYRO_ODR_HZ == 1666 ||
                  IMU_GYRO_ODR_HZ == 3332 || IMU_GYRO_ODR_HZ == 6664,
              "ERROR: IMU_GYRO_ODR_HZ must be a supported LSM6DS3 rate.");
static_assert(
    IMU_ACCEL_BANDWIDTH_HZ == 50 || IMU_ACCEL_BANDWIDTH_HZ == 100 ||
        IMU_ACCEL_BANDWIDTH_HZ == 200 || IMU_ACCEL_BANDWIDTH_HZ == 400,
    "ERROR: IMU_ACCEL_BANDWIDTH_HZ must be one of 50, 100, 200, 400.");

// Enforce each axis sign is a true sign, not a scale factor
// --- Runtime IMU trim ---
static_assert(IMU_GRAVITY_NATIVE > 0.0f,
              "ERROR: IMU_GRAVITY_NATIVE must be greater than 0.");
static_assert(IMU_TRIM_QUALIFY_MS >= IMU_SAMPLE_INTERVAL_MS,
              "ERROR: IMU_TRIM_QUALIFY_MS must span at least one IMU sample.");
static_assert(IMU_TRIM_BLOCK_MS >= IMU_SAMPLE_INTERVAL_MS,
              "ERROR: IMU_TRIM_BLOCK_MS must span at least one IMU sample.");
static_assert(IMU_TRIM_LOCK_BLOCKS >= 1,
              "ERROR: IMU_TRIM_LOCK_BLOCKS must be at least 1.");
static_assert(IMU_TRIM_SPEED_MAX_MPS > 0.0f,
              "ERROR: IMU_TRIM_SPEED_MAX_MPS must be greater than 0.");
static_assert(IMU_TRIM_ACCEL_SANITY_TOL > 0.0f &&
                  IMU_TRIM_ACCEL_SANITY_TOL < 1.0f,
              "ERROR: IMU_TRIM_ACCEL_SANITY_TOL must be in (0.0, 1.0).");
static_assert(IMU_TRIM_ACCEL_VAR_MAX > 0.0f,
              "ERROR: IMU_TRIM_ACCEL_VAR_MAX must be greater than 0.");
static_assert(IMU_TRIM_GYRO_VAR_MAX > 0.0f,
              "ERROR: IMU_TRIM_GYRO_VAR_MAX must be greater than 0.");
// Kept well under 90 degrees: the rotation build is singular at 180, and the
// small-angle regime is the whole design scope.
static_assert(IMU_TRIM_MAX_TILT_DEG > 0.0f && IMU_TRIM_MAX_TILT_DEG < 60.0f,
              "ERROR: IMU_TRIM_MAX_TILT_DEG must be in the range (0, 60).");
static_assert(IMU_TRIM_PVT_STALE_MS > 0,
              "ERROR: IMU_TRIM_PVT_STALE_MS must be greater than 0.");

static_assert(IMU_AXIS_X_SIGN == 1.0f || IMU_AXIS_X_SIGN == -1.0f,
              "ERROR: IMU_AXIS_X_SIGN must be exactly +1.0f or -1.0f.");
static_assert(IMU_AXIS_Y_SIGN == 1.0f || IMU_AXIS_Y_SIGN == -1.0f,
              "ERROR: IMU_AXIS_Y_SIGN must be exactly +1.0f or -1.0f.");
static_assert(IMU_AXIS_Z_SIGN == 1.0f || IMU_AXIS_Z_SIGN == -1.0f,
              "ERROR: IMU_AXIS_Z_SIGN must be exactly +1.0f or -1.0f.");

// Enforce each source index names a real sensor axis.
static_assert(IMU_AXIS_X_SRC >= 0 && IMU_AXIS_X_SRC <= 2,
              "ERROR: IMU_AXIS_X_SRC must be 0 (sensor X), 1 (Y) or 2 (Z).");
static_assert(IMU_AXIS_Y_SRC >= 0 && IMU_AXIS_Y_SRC <= 2,
              "ERROR: IMU_AXIS_Y_SRC must be 0 (sensor X), 1 (Y) or 2 (Z).");
static_assert(IMU_AXIS_Z_SRC >= 0 && IMU_AXIS_Z_SRC <= 2,
              "ERROR: IMU_AXIS_Z_SRC must be 0 (sensor X), 1 (Y) or 2 (Z).");

// Permutation parity: +1 if even, -1 if odd, 0 if any two _SRC collide.
// Integer arithmetic only, so it is usable in a static_assert.
#define IMU_AXIS_PARITY                                                        \
  ((((IMU_AXIS_Y_SRC) - (IMU_AXIS_X_SRC)) *                                    \
    ((IMU_AXIS_Z_SRC) - (IMU_AXIS_X_SRC)) *                                    \
    ((IMU_AXIS_Z_SRC) - (IMU_AXIS_Y_SRC))) /                                   \
   2)

// Catch a duplicated source index with a message that names the real problem,
// rather than letting it fall through to the mirror check below as a 0.
static_assert(IMU_AXIS_PARITY != 0,
              "ERROR: IMU_AXIS_X/Y/Z_SRC must be a permutation - each of "
              "sensor 0, 1 and 2 used exactly once. Two vehicle axes are "
              "currently fed by the same sensor axis.");

// The determinant check, and the reason this scheme is worth having.
//
// The target output frame is right-handed, so any valid mounting map is a
// proper rotation: determinant +1. Determinant = permutation parity x the
// product of the signs, so an even permutation needs an even number of sign
// flips and an odd permutation an odd number. Anything else is a MIRROR - an
// orientation no physical mounting can produce.
//
// This matters because a mirror fails silently and slowly. The data still
// looks entirely plausible; whichever axes are mis-signed are simply wrong,
// for accel and gyro alike, since remapAxes() applies the same matrix to both.
// The shipped non-display config carried exactly this bug for months - X had
// been flipped without Y - and it survived a drive test and an app-side
// investigation before the arithmetic caught it. With 24 orientations to choose
// from instead of 8, hand-deriving a map gets MORE error-prone, so the guard
// earns its keep.
static_assert(IMU_AXIS_PARITY * IMU_AXIS_X_SIGN * IMU_AXIS_Y_SIGN *
                      IMU_AXIS_Z_SIGN ==
                  1.0f,
              "ERROR: axis map is a mirror, not a rotation (determinant -1). "
              "An even permutation needs an even number of sign flips, an odd "
              "permutation an odd number. See the order table in the Axis "
              "orientation section above.");

// Enforce both BLE TX power levels are exact levels the nRF52840 radio
// supports. Bluefruit.setTxPower() rejects (and ignores) any other value at
// runtime, so membership - not just a range - is checked here.
static_assert(
    BLE_TX_POWER_ADV_DBM == -40 || BLE_TX_POWER_ADV_DBM == -20 ||
        BLE_TX_POWER_ADV_DBM == -16 || BLE_TX_POWER_ADV_DBM == -12 ||
        BLE_TX_POWER_ADV_DBM == -8 || BLE_TX_POWER_ADV_DBM == -4 ||
        BLE_TX_POWER_ADV_DBM == 0 || BLE_TX_POWER_ADV_DBM == 2 ||
        BLE_TX_POWER_ADV_DBM == 3 || BLE_TX_POWER_ADV_DBM == 4 ||
        BLE_TX_POWER_ADV_DBM == 5 || BLE_TX_POWER_ADV_DBM == 6 ||
        BLE_TX_POWER_ADV_DBM == 7 || BLE_TX_POWER_ADV_DBM == 8,
    "ERROR: BLE_TX_POWER_ADV_DBM must be an exact nRF52840 level: -40, -20, "
    "-16, -12, -8, -4, 0, 2, 3, 4, 5, 6, 7, or 8.");
static_assert(
    BLE_TX_POWER_CONN_DBM == -40 || BLE_TX_POWER_CONN_DBM == -20 ||
        BLE_TX_POWER_CONN_DBM == -16 || BLE_TX_POWER_CONN_DBM == -12 ||
        BLE_TX_POWER_CONN_DBM == -8 || BLE_TX_POWER_CONN_DBM == -4 ||
        BLE_TX_POWER_CONN_DBM == 0 || BLE_TX_POWER_CONN_DBM == 2 ||
        BLE_TX_POWER_CONN_DBM == 3 || BLE_TX_POWER_CONN_DBM == 4 ||
        BLE_TX_POWER_CONN_DBM == 5 || BLE_TX_POWER_CONN_DBM == 6 ||
        BLE_TX_POWER_CONN_DBM == 7 || BLE_TX_POWER_CONN_DBM == 8,
    "ERROR: BLE_TX_POWER_CONN_DBM must be an exact nRF52840 level: -40, "
    "-20, -16, -12, -8, -4, 0, 2, 3, 4, 5, 6, 7, or 8.");

// Enforce a positive stats-reporting interval.
static_assert(LOG_STATS_INTERVAL_MS > 0,
              "ERROR: LOG_STATS_INTERVAL_MS must be greater than 0.");
static_assert(LOG_LIGHT_SLEEP_INTERVAL_MS > 0,
              "ERROR: LOG_LIGHT_SLEEP_INTERVAL_MS must be greater than 0.");

// Enforce a sane EMA alpha for the displayed voltage smoother.
static_assert(BATTERY_EMA_ALPHA > 0.0f && BATTERY_EMA_ALPHA <= 1.0f,
              "ERROR: BATTERY_EMA_ALPHA must be in between 0.0 and 1.0.");

// Enforce sane, correctly-ordered battery thresholds. The window is bounded
// to a 1S LiPo's usable resting range so a typo can't disable the safety
// cutoff.
static_assert(BATTERY_CUTOFF_V > 3.0f && BATTERY_CUTOFF_V < 3.7f,
              "ERROR: BATTERY_CUTOFF_V must be a resting LiPo voltage between "
              "3.0 and 3.7.");
static_assert(BATTERY_CRITICAL_V > BATTERY_CUTOFF_V &&
                  BATTERY_CRITICAL_V < BATTERY_WARN_V,
              "ERROR: BATTERY_CRITICAL_V must sit between the cutoff and "
              "warn thresholds.");
static_assert(BATTERY_WARN_V > BATTERY_CRITICAL_V && BATTERY_WARN_V < 4.2f,
              "ERROR: BATTERY_WARN_V must be > BATTERY_CRITICAL_V and < 4.2.");
static_assert(BATTERY_FULL_V > BATTERY_WARN_V && BATTERY_FULL_V <= 4.2f,
              "ERROR: BATTERY_FULL_V must be > BATTERY_WARN_V and <= 4.2.");

// Sampler sanity: enough samples per run for min/max to be meaningful; window
// no wider than the poll interval; TACQ one of the values the core supports.
static_assert(BATTERY_SAMPLE_COUNT >= 4 && BATTERY_SAMPLE_COUNT <= 200,
              "ERROR: BATTERY_SAMPLE_COUNT must be 4..200.");
static_assert(BATTERY_SAMPLE_SPACING_US >= 100 &&
                  BATTERY_SAMPLE_SPACING_US <= 10000,
              "ERROR: BATTERY_SAMPLE_SPACING_US must be 100..10000.");
static_assert(
    (uint32_t)BATTERY_SAMPLE_COUNT * (uint32_t)BATTERY_SAMPLE_SPACING_US <
        (uint32_t)BATTERY_POLL_INTERVAL_MS * 1000UL,
    "ERROR: sampler window (BATTERY_SAMPLE_COUNT * BATTERY_SAMPLE_SPACING_US) "
    "must fit inside BATTERY_POLL_INTERVAL_MS.");
static_assert(SAADC_TACQ_US == 3 || SAADC_TACQ_US == 5 || SAADC_TACQ_US == 10 ||
                  SAADC_TACQ_US == 15 || SAADC_TACQ_US == 20 ||
                  SAADC_TACQ_US == 40,
              "ERROR: SAADC_TACQ_US must be one of 3, 5, 10, 15, 20, "
              "40 (values the SAADC supports via analogSampleTime()).");

// Switch-sense threshold sits inside the ADC's readable range.
static_assert(POWER_SWITCH_OFF_THRESHOLD_MV > 0 &&
                  POWER_SWITCH_OFF_THRESHOLD_MV < 3000,
              "ERROR: POWER_SWITCH_OFF_THRESHOLD_MV must be within the ADC "
              "range (0, 3000).");

// Switch-sense timing sanity: a positive poll cadence, and a debounce long
// enough to span several polls so it actually filters noise.
static_assert(POWER_SWITCH_POLL_INTERVAL_MS > 0,
              "ERROR: POWER_SWITCH_POLL_INTERVAL_MS must be greater than 0.");
static_assert(STATE_SWITCH_OFF_DEBOUNCE_MS >= POWER_SWITCH_POLL_INTERVAL_MS,
              "ERROR: STATE_SWITCH_OFF_DEBOUNCE_MS must be >= "
              "POWER_SWITCH_POLL_INTERVAL_MS.");

// LED blink timing sanity.
static_assert(LED_BLINK_INTERVAL_MS > 0,
              "ERROR: LED_BLINK_INTERVAL_MS must be greater than 0.");
static_assert(LED_BATTERY_WAIT_BLINK_MS >= 50 &&
                  LED_BATTERY_WAIT_BLINK_MS <= 1000,
              "ERROR: LED_BATTERY_WAIT_BLINK_MS must be 50..1000.");
static_assert(LED_LIGHT_SLEEP_BLINK_ON_MS > 0 &&
                  LED_LIGHT_SLEEP_BLINK_OFF_MS > 0,
              "ERROR: LED_LIGHT_SLEEP_BLINK_*_MS must be greater than 0.");

// State-machine feature flag: strictly 0 or 1.
static_assert(STATE_CHARGE_ONLY_ON_USB == 0 || STATE_CHARGE_ONLY_ON_USB == 1,
              "ERROR: STATE_CHARGE_ONLY_ON_USB must be 0 or 1.");

// LIGHT_SLEEP timing must be strictly increasing - each tier is measured
// from LIGHT_SLEEP entry (or, for the first tier, from losing the last BLE
// client), so a misordered value would mean a "later" escalation fires
// before an "earlier" one.
static_assert(STATE_IDLE_TIMEOUT_MIN > 0, "ERROR: STATE_IDLE_TIMEOUT_MIN must "
                                          "be greater than 0.");
static_assert(STATE_LIGHT_SLEEP_GNSS_CUTOFF_MIN > 0 &&
                  STATE_LIGHT_SLEEP_GNSS_CUTOFF_MIN <
                      STATE_LIGHT_SLEEP_TIMEOUT_MIN,
              "ERROR: STATE_LIGHT_SLEEP_GNSS_CUTOFF_MIN must be > 0 and < "
              "STATE_LIGHT_SLEEP_TIMEOUT_MIN.");
static_assert(STATE_LIGHT_SLEEP_TIMEOUT_MIN > 0,
              "ERROR: STATE_LIGHT_SLEEP_TIMEOUT_MIN must be greater than 0.");

// GNSS wake pulse must be a positive, sane hold time per level.
static_assert(GNSS_WAKE_PULSE_MS > 0 && GNSS_WAKE_PULSE_MS <= 1000,
              "ERROR: GNSS_WAKE_PULSE_MS must be 1..1000 ms.");

// IMU wake-up threshold is a 6-bit field (0-63); duration is a small packed
// field - bounded generously rather than to its exact bit width, since the
// real constraint is "fits in the register", which the write already masks.
static_assert(IMU_WAKE_THS <= 63, "ERROR: IMU_WAKE_THS must be 0..63 (6-bit "
                                  "field).");
static_assert(IMU_WAKE_DUR <= 15, "ERROR: IMU_WAKE_DUR must be 0..15.");

// Logging feature flag: strictly 0 or 1.
static_assert(LOG_ENABLED == 0 || LOG_ENABLED == 1,
              "ERROR: LOG_ENABLED must be 0 or 1.");

// Battery-gauge feature flag: strictly 0 or 1.
static_assert(BATTERY_HAS_GAUGE == 0 || BATTERY_HAS_GAUGE == 1,
              "ERROR: BATTERY_HAS_GAUGE must be 0 or 1.");
