c20d-us/Gnimu/code/Gnimu/Config.h

// Gnimu - GNSS+IMU streaming telemetry
// Copyright (C) 2026 Chris Halstead
// SPDX-License-Identifier: GPL-3.0-or-later

#pragma once

// Gnimu settings: the values chosen for a build. Each one is checked when the
// firmware compiles (src/app/SystemConfig.h), so a value out of range fails
// the build with a message saying why. The constants the firmware's timing
// and safety depend on are in src/app/SystemConfig.h, not here.

#include <stdint.h>

#include "src/app/ConfigTypes.h"

// Which BLE protocol this build speaks: one binary per protocol. The
// protocol, not the board, decides whether the IMU is sampled at all; a
// RaceChrono build ignores even an onboard IMU. The choices are the files in
// src/variants/protocol/. scripts/build.sh picks one with --protocol; any
// other build uses RaceBox.
#ifndef GNIMU_PROTOCOL_FILE
#define GNIMU_PROTOCOL_FILE "src/variants/protocol/racebox.h"
#endif
#include GNIMU_PROTOCOL_FILE

namespace gnimu {
namespace config {

// GNSS

// Navigation rate, 1-25 Hz.
// 20Hz is the max with 2 constellations.
// 25Hz can only be achieved with 1 constellation.
constexpr uint8_t kGnssNavRateHz = 20;
// Satellites below this elevation are ignored (anti-multipath).
// Valid values are 0-90 degrees.
constexpr uint8_t kGnssMinElevDeg = 5;
// Constellation preference list, most preferred first, each listed once.
// Valid constellations are Gps, Galileo, Beidou, Glonass.
// The first kConstellationCount are enabled.
constexpr GnssSystem kConstellationPriority[] = {
    GnssSystem::Gps, GnssSystem::Galileo, GnssSystem::Beidou,
    GnssSystem::Glonass};
// How many constellations to enable.
// 20Hz needs at most 2, 25Hz at most 1
// Valid values are 1-4.
constexpr unsigned kConstellationCount = 2;

// BLE

// BLE Tx power, low on purpose: less RF near the GNSS antenna, and the client
// is usually close. Raise it if connections drop. Each board validates the
// value against the levels its own radio supports.
// ESP32: -12 to +9 dBm in 3 dB steps
// nRF52840: -40, -20, -16, -12, -8, -4, 0 or 2..8 dBm
constexpr int kBleTxPowerDbm = -12;
// Advertised name is "<prefix> <10-digit device ID>"; the prefix is also the
// Device Information model string. Some apps pick devices out of a scan by
// the name they expect, so change it if yours does. Up to 20 characters.
constexpr char kBleNamePrefix[] = "Gnimu-RB";
// Device Information manufacturer string.
constexpr char kBleManufacturer[] = "Gnimu";

// IMU

// EMA smoothing, 1.0 = raw. Its delay is about (1 - alpha) / alpha samples:
// 0.33 is about 20 ms at 100 Hz, so a packet's IMU value lands near the epoch
// it's sent with, while still damping vibration that would alias into the
// 20 Hz packets. Heavier smoothing trades lag for calm: 0.18 is about 45 ms,
// and 0.09 about 100 ms, which shifts braking and turn-in by about 3 m at
// 30 m/s.
constexpr float kImuAccelAlpha = 0.33f;
constexpr float kImuGyroAlpha = 0.33f;

// The sensor's mounting (which way each of its axes points in the vehicle) is
// part of the hardware profile, not a setting: see src/variants/.

// Battery, for builds that have one

// Cell voltages, ordered cutoff < critical < warning < full scale <= 4.2 V.
// Percent is a straight line from cutoff (0%) to full scale (100%).
constexpr float kBatteryCutoffV = 3.30f;    // System OFF below this, on battery
constexpr float kBatteryCriticalV = 3.35f;  // red blink
constexpr float kBatteryWarningV = 3.40f;   // amber blink
constexpr float kBatteryFullScaleV = 4.10f; // 100%
constexpr float kBatteryChargeFullV = 4.10f; // Rough value for "full"

} // namespace config
} // namespace gnimu
