c20d-us/Gnimu/code/Gnimu/src/peripherals/gnss/Gnss.cpp

// Gnimu - GNSS+IMU streaming telemetry
// Copyright (C) 2026 Chris Halstead
// SPDX-License-Identifier: GPL-3.0-or-later

#include "Gnss.h"

#include <Arduino.h>
#include <SparkFun_u-blox_GNSS_v3.h>

#include "../../app/SystemConfig.h"
#include "../../core/GnssClock.h"
#include "../../platform/Clock.h"
#include "../../platform/GnssUart.h"
#include "../../platform/Watchdog.h"

namespace gnimu {

namespace {

SFE_UBLOX_GNSS_SERIAL receiver;
GnssEpoch latestEpoch;
bool epochPending = false;

// Every library call that waits for a reply feeds the watchdog first, so even
// a receiver that answers nothing never lets it expire. The longest such call
// is detection on a silent port: begin() tries three times, each waiting out
// the full timeout, between tryBaud()'s 100 ms pauses.
static_assert(3 * kUBLOXGNSSDefaultMaxWait + 1000 <= config::kWatchdogMs,
              "watchdog shorter than one GNSS detection attempt plus margin");

// How long the receiver gets to finish erasing its flash before the restart
// that follows a factory reset. Boards that switch the receiver's rail cut its
// power at that restart.
constexpr uint32_t kFactoryResetPauseMs = 1000;

// A setting the receiver must hold, and its human name for the log line.
struct KeyVal {
  uint32_t key;
  uint8_t desired;
  const char *name;
};

// Helper function to drain (and discard) any outstanding data in the UART.
void drainUart() {
  Stream &s = GnssUart::stream();
  while (s.available())
    s.read();
}

// Grab data from an newly received PVT.
void onPvt(UBX_NAV_PVT_data_t *pvt) {
  latestEpoch.arrivalUs = PlatformClock::nowUs();
  latestEpoch.iTowMs = pvt->iTOW;
  latestEpoch.hAccMm = pvt->hAcc;
  latestEpoch.tAccNs = pvt->tAcc;
  latestEpoch.latDeg1e7 = pvt->lat;
  latestEpoch.lonDeg1e7 = pvt->lon;
  latestEpoch.pDop = pvt->pDOP;
  latestEpoch.fixType = pvt->fixType;
  latestEpoch.numSv = pvt->numSV;
  latestEpoch.gSpeedMmPerS = static_cast<uint32_t>(pvt->gSpeed);
  latestEpoch.gnssFixOk = pvt->flags.bits.gnssFixOK;
  latestEpoch.year = pvt->year;
  latestEpoch.month = pvt->month;
  latestEpoch.day = pvt->day;
  latestEpoch.hour = pvt->hour;
  latestEpoch.min = pvt->min;
  latestEpoch.sec = pvt->sec;
  latestEpoch.validDate = pvt->valid.bits.validDate;
  latestEpoch.validTime = pvt->valid.bits.validTime;
  latestEpoch.fullyResolved = pvt->valid.bits.fullyResolved;
  latestEpoch.validMag = pvt->valid.bits.validMag;
  latestEpoch.nanoNs = pvt->nano;
  latestEpoch.heightMm = pvt->height;
  latestEpoch.hMslMm = pvt->hMSL;
  latestEpoch.vAccMm = pvt->vAcc;
  latestEpoch.headMotDeg1e5 = pvt->headMot;
  latestEpoch.sAccMmPerS = pvt->sAcc;
  latestEpoch.headAccDeg1e5 = pvt->headAcc;
  latestEpoch.headVehValid = pvt->flags.bits.headVehValid;
  epochPending = true;
}

// Overloaded on value width so ensureVal<T> can reach the right getVal/setVal
// pair through ordinary overload resolution, without `if constexpr`, which
// needs C++17; the nRF core builds as C++11.
bool getVal(uint32_t key, uint8_t *val, uint8_t layer) {
  return receiver.getVal8(key, val, layer);
}
bool getVal(uint32_t key, uint16_t *val, uint8_t layer) {
  return receiver.getVal16(key, val, layer);
}
bool getVal(uint32_t key, uint32_t *val, uint8_t layer) {
  return receiver.getVal32(key, val, layer);
}
bool setAll(uint32_t key, uint8_t val) {
  return receiver.setVal8(key, val, VAL_LAYER_ALL);
}
bool setAll(uint32_t key, uint16_t val) {
  return receiver.setVal16(key, val, VAL_LAYER_ALL);
}

// A lost or corrupted reply fails the same way as a key that's absent from
// flash, so a single failed read can't tell "never stored" from "reply got
// mangled" - and treating the latter as absent means a needless write plus a
// false failure line. Retrying sorts them apart: a mangled reply is
// transient, while an absent key NAKs every time, in milliseconds, so the
// retries cost almost nothing on a first-ever configuration. No pause between
// attempts: a lost reply already waits out the library's full timeout.
constexpr int kReadAttempts = 3;

template <typename T> bool readLayer(uint32_t key, T *val, uint8_t layer) {
  for (int attempt = 0; attempt < kReadAttempts; attempt++) {
    Watchdog::feed();
    if (getVal(key, val, layer))
      return true;
  }
  return false;
}

// VALGET's wire layer for OTP. The library only names RAM, BBR and flash, and
// sends any other layer as the default one, so the request is built with the
// library and the layer byte is then set by hand.
constexpr uint8_t kValgetLayerOtp = 4;
constexpr uint16_t kOtpReplyWaitMs = 400;
constexpr int kOtpReadAttempts = 2;

// True if OTP holds the high clock. A receiver with nothing in OTP either
// NAKs or says nothing, so both end as false; the caller has already shown
// the receiver is answering.
bool otpHoldsHighClockNow() {
  uint8_t payload[48]; // the 36-byte reply with room to spare
  ubxPacket pkt = {0, 0, 0, 0, 0, payload, 0, 0, SFE_UBLOX_PACKET_VALIDITY_NOT_DEFINED,
                   SFE_UBLOX_PACKET_VALIDITY_NOT_DEFINED};
  for (int attempt = 0; attempt < kOtpReadAttempts; attempt++) {
    receiver.newCfgValget(&pkt, sizeof(payload), VAL_LAYER_RAM);
    for (uint32_t key : kGnssClockKeys)
      receiver.addCfgValget(&pkt, key);
    pkt.payload[1] = kValgetLayerOtp;
    Watchdog::feed();
    if (receiver.sendCfgValget(&pkt, kOtpReplyWaitMs))
      return otpHoldsHighClock(payload, 4 + 4 * 8);
  }
  return false;
}

} // namespace

// Opens the port at `baud` and looks for the receiver. Leaves the port open on
// success and closed on failure.
bool Gnss::tryBaud(uint32_t baud) {
  log_->log("GNSS: trying %lu baud", static_cast<unsigned long>(baud));
  GnssUart::begin(baud);
  delay(100);
  Watchdog::feed();
  if (receiver.begin(GnssUart::stream())) {
    log_->log("GNSS: detected at %lu baud ✅",
              static_cast<unsigned long>(baud));
    return true;
  }
  GnssUart::end();
  delay(100);
  return false;
}

// Switches a receiver found at another rate to the configured one, then writes
// the baud to flash so that the rate persists.
bool Gnss::switchToTargetBaud() {
  log_->log("GNSS: switching to %lu baud",
            static_cast<unsigned long>(config::kGnssBaud));
  // The result is ignored on purpose: the receiver switches baud before its
  // ACK goes out, so the library can't report success (its own note). The
  // reconnect at the new rate below is the real check.
  Watchdog::feed();
  receiver.setSerialRate(config::kGnssBaud);
  delay(100);
  GnssUart::end();
  delay(100);
  GnssUart::begin(config::kGnssBaud);
  delay(100);
  Watchdog::feed();
  if (!receiver.begin(GnssUart::stream())) {
    log_->log("GNSS: could not verify the new baud rate ❌");
    return false;
  }
  Watchdog::feed();
  if (receiver.saveConfigSelective(VAL_CFG_SUBSEC_IOPORT)) {
    log_->log("GNSS: new baud rate saved to flash ✅");
  } else {
    log_->log("GNSS: unable to save new baud rate to flash ❌");
  }
  return true;
}

// Try the target rate first, then the sweep rest if needed.
bool Gnss::connectAtBaud() {
  if (tryBaud(config::kGnssBaud))
    return true;
  for (uint32_t rate : config::kGnssBaudRates) {
    if (rate == config::kGnssBaud)
      continue;
    if (tryBaud(rate))
      return switchToTargetBaud();
  }
  return false;
}

// The receiver runs on its RAM layer, built at startup from defaults, then
// flash, then BBR (battery-backed RAM, which overrides flash). So RAM is
// what's checked: a stale BBR value shows up there even when flash looks
// right. A matching RAM value is all a normal boot reads. Anything else is
// written to every layer (RAM, BBR and flash together, so a stale BBR value
// is overwritten too) and then judged by readback alone - a write whose ACK
// got lost can still have landed:
//   RAM still wrong (or no reply)  -> "could not be set" X, fatal (false)
//   RAM right, flash right         -> "written"
//   RAM right, flash wrong         -> "not saved to flash", a warning: right
//                                     for this run, rewritten next boot
// Flash wrong while BBR holds the right value isn't visible here, and needn't
// be: it's harmless while BBR lasts, and once BBR is lost that boot's RAM is
// wrong, so it gets caught and fixed then.
//
// Check::FlashOnly is for the NAV-PVT output key, which configure() holds at
// 0 in RAM on purpose while it works. Its persisted value is what's checked,
// and failing to persist it is only a warning: whether output actually flows
// is the liveness check's job.
//
// Every key logs one line, so the boot log is a complete record of what the
// receiver held and what had to be written.
template <typename T>
bool Gnss::ensureVal(uint32_t key, T desired, const char *name, Check check) {
  const uint8_t layer = check == Check::Ram ? VAL_LAYER_RAM : VAL_LAYER_FLASH;
  T current = 0;
  if (readLayer(key, &current, layer) && current == desired) {
    log_->log("GNSS: %s=%u ✅", name, static_cast<unsigned>(desired));
    return true;
  }
  Watchdog::feed();
  setAll(key, desired);
  const bool set = readLayer(key, &current, layer) && current == desired;
  if (!set && check == Check::Ram) {
    log_->log("GNSS: %s=%u could not be set ❌", name, static_cast<unsigned>(desired));
    return false;
  }
  const bool saved = check == Check::Ram
                         ? readLayer(key, &current, VAL_LAYER_FLASH) && current == desired
                         : set;
  if (saved) {
    log_->log("GNSS: %s=%u written ⏬", name, static_cast<unsigned>(desired));
  } else {
    log_->log("GNSS: %s=%u set, not saved to flash ⚠️", name, static_cast<unsigned>(desired));
    flashWarnings_++;
  }
  return true;
}

// Reports the CPU clock; never a failure. RAM shows what the receiver is
// running, OTP what it will run after its next start, which a burn leaves
// out of RAM until then.
void Gnss::checkClock() {
  uint32_t ramHz = 0;
  const bool ramRead = readLayer(kGnssClockKeys[0], &ramHz, VAL_LAYER_RAM);
  const bool ramHigh = ramRead && ramHz == kGnssHighClockHz[0];
  const bool otpHigh = ramRead && !ramHigh && otpHoldsHighClockNow();
  // A reply that came in after its wait must not be taken for the next read's.
  drainUart();
  clock_ = classifyClock(ramRead, ramHigh, otpHigh);
  log_->log("GNSS: CPU clock %s %s", gnssClockText(clock_),
            clock_ == GnssClockState::Active ? "✅" : "⚠️");
}

bool Gnss::configure() {
  // Let the receiver settle and then clear any bytes left from the baud
  // handshake so the first configuration reads/ACKs parse cleanly.
  delay(500);
  drainUart();

  // NAV-PVT output is stored on in flash (below), so a receiver that resets
  // mid-session resumes on its own - but that also starts it at power-up.
  // Paused in RAM only for the reads and writes below, so they run on a quiet
  // line; the callback registration at the end turns it back on.
  // This first write is the one that competes with the traffic it stops, so
  // its ACK can be lost among PVT frames; retried, each try on a freshly
  // drained line. Repeating a 0 is harmless if an earlier try took.
  constexpr int kPauseAttempts = 3;
  int attempt = 1;
  bool paused = false;
  for (; attempt <= kPauseAttempts; attempt++) {
    if (attempt > 1) drainUart();
    Watchdog::feed();
    paused = receiver.setVal8(UBLOX_CFG_MSGOUT_UBX_NAV_PVT_UART1, 0, VAL_LAYER_RAM);
    if (paused) break;
  }
  if (paused && attempt > 1) {
    log_->log("GNSS: NAV-PVT output paused for configuration \xE2\x9C\x85 (attempt %d)", attempt);
  } else {
    log_->log("GNSS: NAV-PVT output paused for configuration %s", paused ? "\xE2\x9C\x85" : "\xE2\x9D\x8C");
  }
  drainUart();

  bool selected[4] = {};
  for (unsigned i = 0; i < config::kConstellationCount; i++)
    selected[static_cast<unsigned>(config::kConstellationPriority[i])] = true;
  const auto on = [&](config::GnssSystem s) -> uint8_t {
    return selected[static_cast<unsigned>(s)] ? 1 : 0;
  };

  // Every setting the receiver must hold. ensureVal logs one line per key (its
  // outcomes are listed above it), so a normal boot shows all ✅.
  const KeyVal settings[] = {
      {UBLOX_CFG_NAVSPG_DYNMODEL, config::kGnssDynamicModel, "dynamic model"},
      {UBLOX_CFG_UART1OUTPROT_UBX, 1, "UBX output enable"},
      {UBLOX_CFG_UART1OUTPROT_NMEA, 0, "NMEA output enable"},
      {UBLOX_CFG_MSGOUT_NMEA_ID_DTM_UART1, 0, "NMEA DTM rate"},
      {UBLOX_CFG_MSGOUT_NMEA_ID_GBS_UART1, 0, "NMEA GBS rate"},
      {UBLOX_CFG_MSGOUT_NMEA_ID_GGA_UART1, 0, "NMEA GGA rate"},
      {UBLOX_CFG_MSGOUT_NMEA_ID_GLL_UART1, 0, "NMEA GLL rate"},
      {UBLOX_CFG_MSGOUT_NMEA_ID_GNS_UART1, 0, "NMEA GNS rate"},
      {UBLOX_CFG_MSGOUT_NMEA_ID_GRS_UART1, 0, "NMEA GRS rate"},
      {UBLOX_CFG_MSGOUT_NMEA_ID_GSA_UART1, 0, "NMEA GSA rate"},
      {UBLOX_CFG_MSGOUT_NMEA_ID_GST_UART1, 0, "NMEA GST rate"},
      {UBLOX_CFG_MSGOUT_NMEA_ID_GSV_UART1, 0, "NMEA GSV rate"},
      {UBLOX_CFG_MSGOUT_NMEA_ID_RLM_UART1, 0, "NMEA RLM rate"},
      {UBLOX_CFG_MSGOUT_NMEA_ID_RMC_UART1, 0, "NMEA RMC rate"},
      {UBLOX_CFG_MSGOUT_NMEA_ID_VLW_UART1, 0, "NMEA VLW rate"},
      {UBLOX_CFG_MSGOUT_NMEA_ID_VTG_UART1, 0, "NMEA VTG rate"},
      {UBLOX_CFG_MSGOUT_NMEA_ID_ZDA_UART1, 0, "NMEA ZDA rate"},
      {UBLOX_CFG_NAVSPG_INFIL_MINELEV, config::kGnssMinElevDeg,
       "minimum SV elevation"},
      // BeiDou B1I and B1C are mutually exclusive: B1I is always off, and B1C
      // follows BeiDou's selection. The other systems' signal keys follow
      // theirs.
      {UBLOX_CFG_SIGNAL_BDS_B1_ENA, 0, "BeiDou B1I signal"},
      {UBLOX_CFG_SIGNAL_BDS_B1C_ENA, on(config::GnssSystem::Beidou),
       "BeiDou B1C signal"},
      {UBLOX_CFG_SIGNAL_GPS_L1CA_ENA, on(config::GnssSystem::Gps),
       "GPS L1C/A signal"},
      {UBLOX_CFG_SIGNAL_GAL_E1_ENA, on(config::GnssSystem::Galileo),
       "Galileo E1 signal"},
      {UBLOX_CFG_SIGNAL_GLO_L1_ENA, on(config::GnssSystem::Glonass),
       "GLONASS L1 signal"},
      {UBLOX_CFG_SIGNAL_GPS_ENA, on(config::GnssSystem::Gps), "GPS enable"},
      {UBLOX_CFG_SIGNAL_GAL_ENA, on(config::GnssSystem::Galileo),
       "Galileo enable"},
      {UBLOX_CFG_SIGNAL_BDS_ENA, on(config::GnssSystem::Beidou),
       "BeiDou enable"},
      {UBLOX_CFG_SIGNAL_GLO_ENA, on(config::GnssSystem::Glonass),
       "GLONASS enable"},
      // QZSS and SBAS always disabled
      {UBLOX_CFG_SIGNAL_QZSS_ENA, 0, "QZSS enable"},
      {UBLOX_CFG_SIGNAL_SBAS_ENA, 0, "SBAS enable"},
  };

  bool allOk = true;
  flashWarnings_ = 0;
  for (const auto &s : settings)
    allOk &= ensureVal<uint8_t>(s.key, s.desired, s.name);
  // Output rate is measurement interval x nav ratio. There's no single "nav
  // Hz" key, so both values have to be pinned: RATE_MEAS controls the interval
  // in milliseconds, and RATE_NAV=1 ensures every measurement produces a PVT.
  log_->log("GNSS: setting Nav frequency to %uHz",
            static_cast<unsigned>(config::kGnssNavRateHz));
  allOk &= ensureVal<uint16_t>(UBLOX_CFG_RATE_NAV, 1, "nav ratio"); // always 1
  allOk &= ensureVal<uint16_t>(UBLOX_CFG_RATE_MEAS, 1000 / config::kGnssNavRateHz,
                               "nav rate");
  // Last: on a first-ever write this also turns output on in RAM (the write
  // goes to every layer), so nothing after it competes with the traffic.
  ensureVal<uint8_t>(UBLOX_CFG_MSGOUT_UBX_NAV_PVT_UART1, 1, "NAV-PVT output rate",
                     Check::FlashOnly);
  if (!allOk) {
    log_->log("GNSS: configuration failed - a setting could not be applied ❌");
  } else if (flashWarnings_ > 0) {
    log_->log("GNSS: %u setting(s) not saved to flash - in effect now, rewritten next boot ⚠️",
              flashWarnings_);
  }
  checkClock();

  // Callback is registered last, once the receiver is fully configured. It
  // also turns PVT output back on - in RAM only, since flash already holds it
  // (above). The callback itself is local firmware state, so there's nothing
  // to read back and compare. A missing ACK is only a warning: it can be lost
  // among the very PVT traffic it just enabled, and the liveness check is the
  // real test that epochs flow.
  log_->log("GNSS: Configuring PVT callback and auto PVT output");
  Watchdog::feed();
  if (receiver.setAutoPVTcallbackPtr(&onPvt, VAL_LAYER_RAM)) {
    log_->log("GNSS: PVT callback and auto PVT output enabled ✅");
  } else {
    log_->log("GNSS: PVT output enable not acknowledged - the liveness check will tell ⚠️");
  }
  return allOk;
}

void Gnss::factoryReset() {
  log_->log("GNSS: factory reset");
  Watchdog::feed();
  receiver.factoryReset();
  delay(kFactoryResetPauseMs);
  Watchdog::feed();
}

bool Gnss::begin(Console &log) {
  log_ = &log;
  configured_ = false;
  clock_ = GnssClockState::Unchecked;
  if (!connectAtBaud())
    return false;
  configured_ = configure();
  return true;
}

void Gnss::poll() {
  // Callbacks only become pending when bytes have arrived.
  if (receiver.checkUblox())
    receiver.checkCallbacks();
}

void Gnss::end() {
  GnssUart::end();
  epochPending = false;
}

bool Gnss::consumeEpoch(GnssEpoch &out) {
  if (!epochPending)
    return false;
  epochPending = false;
  out = latestEpoch;
  return true;
}

} // namespace gnimu
