c20d-us/Gnimu/classic/src/Gnimu-nRF52840-OLED/g_imu.cpp

// Gnimu - RaceBox Mini-compatible GNSS+IMU streaming telemetry
// Copyright (C) 2026 Chris Halstead
//
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
#include "g_imu.h"
#include "ImuAxis.h"
#include "config.h"
#include "g_gnss.h"
#include "g_imu_trim.h"
#include "g_log.h"
#include <LSM6DS3.h>
#include <Wire.h> // Wire1, for the setClock() below

// IMU driver. I2C at IMU_I2C_ADDRESS (0x6A).
static LSM6DS3 myIMU(I2C_MODE, IMU_I2C_ADDRESS);

// Three axes each for accelerometer and gyroscope, indexed [0]=X, [1]=Y,
// [2]=Z. Arrays let imuBegin()/imuPoll() drive all three axes of a sensor
// with one loop instead of one line per axis.
static ImuAxis accelAxes[3] = {
    ImuAxis(IMU_ACCEL_ALPHA, IMU_ACCEL_TRANSIENT_THRESHOLD_G),
    ImuAxis(IMU_ACCEL_ALPHA, IMU_ACCEL_TRANSIENT_THRESHOLD_G),
    ImuAxis(IMU_ACCEL_ALPHA, IMU_ACCEL_TRANSIENT_THRESHOLD_G),
};
static ImuAxis gyroAxes[3] = {
    ImuAxis(IMU_GYRO_ALPHA, IMU_GYRO_TRANSIENT_THRESHOLD_DPS),
    ImuAxis(IMU_GYRO_ALPHA, IMU_GYRO_TRANSIENT_THRESHOLD_DPS),
    ImuAxis(IMU_GYRO_ALPHA, IMU_GYRO_TRANSIENT_THRESHOLD_DPS),
};

// Latest values decimated to the transmission rate, refreshed by imuPoll().
// Kept as a plain cache so imuReadProtocolUnits() stays a cheap, side-effect
// free accessor safe to call from multiple places (BLE packet send and serial
// debug reporting both read it).
static ImuProtocolUnits latestUnits = {0, 0, 0, 0, 0, 0};

// False until bring-up succeeds, and latched false for the rest of the session
// if a later reconfiguration fails. While false every IMU field reads zero and
// GNSS, BLE and telemetry carry on without it.
static bool imuUp = false;

// Mark the IMU down for the rest of the session. Logs once.
static void markImuDown() {
  imuUp = false;
  latestUnits = {0, 0, 0, 0, 0, 0};
  LOG_PRINTLN("❌ IMU not answering - continuing without it: IMU fields will "
              "read zero.");
}

// A single raw IMU sample, split into per-axis arrays indexed [0]=X, [1]=Y,
// [2]=Z, matching accelAxes/gyroAxes.
struct ImuRawSample {
  float accel[3]; // g (LSM6DS3 native units)
  float gyro[3];  // deg/s (LSM6DS3 native units)
};

// ============================================================================
// Axis remap - installed orientation. Maps the sensor frame into the vehicle
// frame. The mounting correction itself (IMU_AXIS_*_SRC / _SIGN) lives in
// config.h, along with the order table, the derivation procedure, and the
// static_asserts that reject a physically impossible map.
//
// A general permutation cannot be done in place - writing triple[0] would
// clobber a value a later axis still needs to read - so work from a copy. Three
// floats of stack, and it keeps the mapping a plain declarative read of the
// config rather than a sequence of conditional swaps.
// ============================================================================
static void remapAxes(float triple[3]) {
  const float in[3] = {triple[0], triple[1], triple[2]};
  triple[0] = in[IMU_AXIS_X_SRC] * IMU_AXIS_X_SIGN;
  triple[1] = in[IMU_AXIS_Y_SRC] * IMU_AXIS_Y_SIGN;
  triple[2] = in[IMU_AXIS_Z_SRC] * IMU_AXIS_Z_SIGN;
}

// Convert a scaled sensor value (gyro in centi-deg/sec, accel in milli-g) to
// the protocol's int16_t, saturating at the representable ±32767 limit rather
// than overflowing. A wrapped overflow would flip sign (i.e., reporting a hard
// left spin as a right one), so we clamp to the extreme. The gyro can exceed
// range at ±500°/s; the accelerometer stays well within it even at the max ±g
// but goes through here too so all six fields follow one consistent, safe
// pattern.
static int16_t toProtocolInt16(float value) {
  if (value > 32767.0f)
    return 32767;
  if (value < -32768.0f)
    return -32768;
  return (int16_t)value;
}

// Reassemble a little-endian register pair, matching the byte order the
// library's own readRegisterInt16() uses (low byte first).
static inline int16_t rawPair(const uint8_t *p) {
  return (int16_t)((uint16_t)p[0] | ((uint16_t)p[1] << 8));
}

// Fetch GNSS ground speed for the trim gate, in m/s.
//
// gnssLatestPvt() rather than gnssConsumePvt(): the latter is consume-once and
// belongs to g_telemetry, so a second consumer here would race it and drop BLE
// packets. See g_gnss.h.
//
// Staleness is this caller's problem - gnssLatestPvt() hands back the last
// epoch however old, so a receiver that died mid-drive would otherwise freeze
// at a stale 0 m/s and let the stationary gate pass while moving. Watch iTOW
// and stop trusting the speed once it has stalled for IMU_TRIM_PVT_STALE_MS.
static bool trimSpeedMps(float *speedMps) {
  static uint32_t lastITOW = 0;
  static uint16_t staleSamples = 0;
  static const uint16_t kStaleMax =
      (uint16_t)(IMU_TRIM_PVT_STALE_MS / IMU_SAMPLE_INTERVAL_MS);

  const UBX_NAV_PVT_data_t *pvt = gnssLatestPvt();
  if (pvt == nullptr)
    return false;

  if (pvt->iTOW != lastITOW) {
    lastITOW = pvt->iTOW;
    staleSamples = 0;
  } else if (staleSamples < kStaleMax) {
    staleSamples++;
  }
  if (staleSamples >= kStaleMax)
    return false;

  // 3D fix only - the same strict read of "valid" that g_telemetry reserves for
  // lat/lon. This was briefly relaxed to accept a 2D fix, on the grounds that
  // requiring 3D suspended trim learning under marginal sky. Locking the
  // orientation after one window removed that argument: there is no ongoing
  // accelerometer learning left to protect, and the single window that matters
  // happens in the paddock under clear sky, where a 3D fix is a given. Strict
  // costs nothing there and buys a stronger validity guarantee.
  //
  // One gate serves both halves, so this also pauses GYRO refinement under a
  // poor fix. Accepted deliberately: the gyro only needs to land occasionally
  // to track thermal drift, and a second gate is not worth the extra constant
  // or the longer explanation.
  if (pvt->fixType != 3 || !pvt->flags.bits.gnssFixOK)
    return false;

  *speedMps = (float)pvt->gSpeed * 0.001f; // mm/s -> m/s
  return true;
}

// Read one sample: accel (g) / gyro (deg/s), remapped into the vehicle frame
// and runtime-trimmed.
//
// There is no build-time zero correction: the runtime trim measures the total
// resting error, chip bias and mounting tilt together, so the firmware image
// is identical across boards.
static ImuRawSample readImuRaw() {
  // Last good sample, reused if a read fails - see the error branch below.
  // Zero-initialised, so a failure before the very first successful read
  // yields zeros rather than stack garbage.
  static ImuRawSample lastGood = {{0.0f, 0.0f, 0.0f}, {0.0f, 0.0f, 0.0f}};

  ImuRawSample s;

  // ONE burst for all six axes rather than six separate two-transaction
  // reads. OUTX_L_G (0x22) through OUTZ_H_XL (0x2D) is 12 contiguous bytes -
  // gyro X/Y/Z then accel X/Y/Z - so this is 2 I2C transactions instead of 12.
  //
  // Speed is the lesser reason. The real one is SAMPLE COHERENCY: BDU (set in
  // configureNormalMode) freezes each register PAIR so a 16-bit read cannot
  // straddle a sample, but six separate transactions still leave gaps in which
  // a new sample can land - so X could come from one sample and Z from the
  // next. A single burst returns one coherent six-axis set, which matters when
  // the values feed per-chip offset correction, an axis remap, and a
  // transient-peak detector that is specifically looking for short events.
  uint8_t raw[12];
  if (myIMU.readRegisterRegion(raw, LSM6DS3_ACC_GYRO_OUTX_L_G, sizeof(raw)) !=
      IMU_SUCCESS) {
    // Reuse the previous sample rather than feeding a failed read into the
    // filters. The old per-axis path had no such guard: a bad transfer went
    // straight into the EMA and, worse, into the transient-peak window, where
    // one bogus value is latched as a "peak" and reported as a real event.
    // Deliberately silent - this runs at IMU_SAMPLE_INTERVAL_MS, and logging
    // per failure would be its own latency problem on a flaky bus.
    return lastGood;
  }

  s.gyro[0] = myIMU.calcGyro(rawPair(&raw[0]));
  s.gyro[1] = myIMU.calcGyro(rawPair(&raw[2]));
  s.gyro[2] = myIMU.calcGyro(rawPair(&raw[4]));
  s.accel[0] = myIMU.calcAccel(rawPair(&raw[6]));
  s.accel[1] = myIMU.calcAccel(rawPair(&raw[8]));
  s.accel[2] = myIMU.calcAccel(rawPair(&raw[10]));

  remapAxes(s.accel);
  remapAxes(s.gyro);

  // Runtime trim, in the vehicle frame. Update BEFORE apply and on the
  // uncorrected values: feeding the estimator its own output would close the
  // loop and make imuTrimTiltDegrees() decay toward zero as it converged,
  // which is exactly wrong for a mounting guard that needs the absolute tilt.
  //
  // Both sit after the failed-read early return above, so a bad I2C transfer
  // never reaches the estimator. That matters more than it looks: a repeated
  // lastGood sample would read as zero variance and falsely satisfy the
  // stillness gate.
  float speedMps = 0.0f;
  const bool speedValid = trimSpeedMps(&speedMps);
  imuTrimUpdate(s.accel, s.gyro, speedMps, speedValid);
  imuTrimApply(s.accel, s.gyro);

  lastGood = s;
  return s;
}

// Shared by imuBegin() and imuDisarmWake(): (re)apply normal-operation
// ranges/ODR/bandwidth, BDU, and re-seed the axis filters. Does not touch
// the power pin as callers that need the chip powered on do that themselves.
// False if the IMU did not answer.
static bool configureNormalMode() {
  // Configure ranges / output data rates / bandwidth from config.h. The Seeed
  // library takes plain integers here and applies them in begin(); it also
  // brings up its own I2C bus internally - no manual Wire/Wire1 setup needed.
  myIMU.settings.accelEnabled = 1;
  myIMU.settings.accelRange = IMU_ACCEL_RANGE_G;
  myIMU.settings.accelSampleRate = IMU_ACCEL_ODR_HZ;
  myIMU.settings.accelBandWidth = IMU_ACCEL_BANDWIDTH_HZ; // anti-aliasing
  myIMU.settings.gyroEnabled = 1;
  myIMU.settings.gyroRange = IMU_GYRO_RANGE_DPS;
  myIMU.settings.gyroSampleRate = IMU_GYRO_ODR_HZ;
  myIMU.settings.tempEnabled = 0; // unused by this firmware

  // The Seeed library returns 0 (IMU_SUCCESS) on success.
  if (myIMU.begin() != 0)
    return false;

  // Raise the IMU bus above the core's 100kHz default. MUST come after
  // begin(): the library calls Wire1.begin() internally, which hardcodes the
  // TWIM FREQUENCY register, so anything set earlier is silently overwritten.
  // Re-applied on every call because imuDisarmWake() runs begin() again on
  // each LIGHT_SLEEP exit. See IMU_I2C_CLOCK_HZ in config.h for why this
  // matters to loop() latency.
  Wire1.setClock(IMU_I2C_CLOCK_HZ);

  // Enable Block Data Update on CTRL3_C: freezes each 16-bit output register
  // between its low- and high-byte reads, so a two-byte fetch can never
  // straddle a sample rollover (torn read). At our 104 Hz ODR samples refresh
  // every ~9.6 ms, well inside the window of any BLE/serial hiccup.
  myIMU.writeRegister(LSM6DS3_ACC_GYRO_CTRL3_C,
                      LSM6DS3_ACC_GYRO_BDU_BLOCK_UPDATE |
                          LSM6DS3_ACC_GYRO_IF_INC_ENABLED);

  // Fully disable the wake-up detector, not just un-route it (harmless no-op
  // on the very first call, before it's ever been armed). Un-routing MD1_CFG
  // alone leaves TAP_CFG1's INTERRUPTS_ENABLE bit live, so the slope detector
  // keeps running continuously in the background for the entire RUNNING
  // period, and since LIR latches it, any real motion during that window
  // (device handled, table bumped) sets WAKE_UP_SRC well before the next
  // imuArmWake() ever runs.
  // Clearing TAP_CFG1 here gives every imuArmWake() the same clean 0x00 ->
  // 0x8F transition that worked on the first cycle.
  myIMU.writeRegister(LSM6DS3_ACC_GYRO_TAP_CFG1, 0x00);
  myIMU.writeRegister(LSM6DS3_ACC_GYRO_MD1_CFG, 0x00);

  // Seed each axis with a real first reading rather than leaving it at its
  // zero-baseline default. Otherwise the first update() would see a huge
  // artificial jump (e.g. gravity on the Z axis) that gets latched into the
  // window's peak deviation and misreported as a genuine transient in the
  // very first transmitted frame.
  ImuRawSample seed = readImuRaw();
  for (int i = 0; i < 3; i++) {
    accelAxes[i].reset(seed.accel[i]);
    gyroAxes[i].reset(seed.gyro[i]);
  }
  return true;
}

// Never halts: a missing IMU leaves it down, and the rest of the device runs
// without it.
void imuBegin() {
  // Power the onboard LSM6DS3TR-C, then give it time to boot before I2C. Pin
  // 15 driven HIGH enables it.
  pinMode(IMU_POWER_PIN, OUTPUT);
  digitalWrite(IMU_POWER_PIN, HIGH);
  delay(300); // wait for IMU to boot and settle

  // Ahead of configureNormalMode(), which seeds the axis filters with a live
  // readImuRaw() and would otherwise reach the trim before it has a config.
  //
  // Deliberately NOT in configureNormalMode() itself: that also runs on every
  // LIGHT_SLEEP exit, and the mount has not changed across a sleep. Resetting
  // there would throw away a good estimate and re-serve the whole convergence
  // delay for nothing.
  const ImuTrimConfig trimCfg = {
      IMU_GRAVITY_NATIVE,      (float)IMU_SAMPLE_INTERVAL_MS,
      IMU_TRIM_QUALIFY_MS,     IMU_TRIM_BLOCK_MS,
      IMU_TRIM_LOCK_BLOCKS,    IMU_TRIM_SPEED_MAX_MPS,
      IMU_TRIM_ACCEL_SANITY_TOL, IMU_TRIM_ACCEL_VAR_MAX,
      IMU_TRIM_GYRO_VAR_MAX,   IMU_TRIM_MAX_TILT_DEG,
      (bool)IMU_TRIM_REQUIRE_FIX,
  };
  imuTrimBegin(trimCfg);

  if (!configureNormalMode()) {
    markImuDown();
    return;
  }
  imuUp = true;
  LOG_PRINTLN("✅ IMU Accelerometer/Gyro enabled.");
}

// LIGHT_SLEEP wake-up detector (AN4650)
// Registers touched, beyond the ones configureNormalMode() already owns:
//   TAP_CFG (0x58)     - bit7 INTERRUPTS_ENABLE, bit0 LIR (latch), bits3:1
//                        enable X/Y/Z in the wake-up slope detector.
//   WAKE_UP_THS (0x5B) - 6-bit threshold (IMU_WAKE_THS).
//   WAKE_UP_DUR (0x5C) - debounce, in ODR cycles (IMU_WAKE_DUR).
//   MD1_CFG (0x5E)     - bit5 INT1_WU routes the wake-up interrupt to INT1.
//   WAKE_UP_SRC (0x1B) - reading this clears the latched interrupt.
static bool wakeArmed = false;

void imuArmWake() {
  // With the IMU down only a BLE connect wakes LIGHT_SLEEP.
  if (!imuUp)
    return;
  pinMode(IMU_INT1_PIN, INPUT); // push-pull active-high chip output

  myIMU.writeRegister(LSM6DS3_ACC_GYRO_CTRL1_XL, IMU_WAKE_CTRL1_XL);
  myIMU.writeRegister(LSM6DS3_ACC_GYRO_TAP_CFG1,
                      0x8F); // INTERRUPTS_ENABLE|LIR|X_EN|Y_EN|Z_EN
  myIMU.writeRegister(LSM6DS3_ACC_GYRO_WAKE_UP_THS, IMU_WAKE_THS & 0x3F);
  myIMU.writeRegister(LSM6DS3_ACC_GYRO_WAKE_UP_DUR, IMU_WAKE_DUR);
  // MD1_CFG intentionally NOT written yet - stay un-routed from INT1 until
  // WAKE_UP_SRC has been flushed below, so nothing stale (or freshly
  // generated by the CTRL1_XL switch itself) can reach the pin before we've
  // had a chance to clear it.

  // The CTRL1_XL write above is a live mode switch (104Hz/+-4g while RUNNING
  // -> 12.5Hz/+-2g here), not a cold power-on into this config - unlike
  // src/tools/nRF52840/imu_wake, which only ever powered on directly into the wake
  // config. Changing ODR/full-scale on an already-running chip produces a
  // settling transient in the accelerometer's internal filter chain that's
  // large enough to trip WAKE_UP_THS on its own. Give it a couple of ODR
  // periods (12.5Hz -> 80ms/sample) to settle, then discard whatever that
  // transient (or anything stale left over from the last cycle) latched
  // into WAKE_UP_SRC before routing to INT1 - a single read fully clears the
  // latch (it's not a FIFO), but only if nothing's already been routed out
  // to the pin first.
  delay(250);
  uint8_t discard = 0;
  myIMU.readRegister(&discard, LSM6DS3_ACC_GYRO_WAKE_UP_SRC);

  myIMU.writeRegister(LSM6DS3_ACC_GYRO_MD1_CFG, 0x20); // INT1_WU - now safe

  wakeArmed = true;
  LOG_PRINTLN("🌙 IMU wake-up detector armed (low-power ODR).");
}

bool imuWakeTriggered() {
  if (!wakeArmed)
    return false;
  if (digitalRead(IMU_INT1_PIN) != HIGH)
    return false;

  uint8_t src = 0;
  myIMU.readRegister(&src, LSM6DS3_ACC_GYRO_WAKE_UP_SRC); // clears the latch
  return true;
}

void imuDisarmWake() {
  if (!imuUp)
    return;
  wakeArmed = false;
  // Restores ODR/range and un-routes MD1_CFG.
  if (!configureNormalMode()) {
    markImuDown();
    return;
  }
  LOG_PRINTLN("☀️ IMU wake-up detector disarmed, normal ODR restored.");
}

// Poll the IMU and update the axis filters at our configured sample rate.
// Both cadences below are deadline-anchored (the anchor advances by the
// interval, not to "now"), so per-loop latency doesn't stretch every period
// and quietly drop the real rates below their configured values. If the loop
// ever falls more than one full interval behind, the anchor resyncs to now
// rather than firing a rapid catch-up burst.
void imuPoll() {
  static unsigned long lastImuReadMs = 0;
  static unsigned long lastTransmitReadMs = 0;
  const unsigned long nowMs = millis();

  if (!imuUp)
    return; // latestUnits stays zero

  // Update all six axis filters if it's time to sample.
  if (nowMs - lastImuReadMs >= IMU_SAMPLE_INTERVAL_MS) {
    lastImuReadMs += IMU_SAMPLE_INTERVAL_MS;
    if (nowMs - lastImuReadMs >= IMU_SAMPLE_INTERVAL_MS) {
      lastImuReadMs = nowMs; // fell > 1 interval behind - resync
    }
    ImuRawSample raw = readImuRaw();
    for (int i = 0; i < 3; i++) {
      accelAxes[i].update(raw.accel[i]);
      gyroAxes[i].update(raw.gyro[i]);
    }
  }

  // Decimate to the transmission rate on a fixed cadence, regardless of BLE
  // connection state. This is what drains each axis's transient window; if it
  // only ran while connected, the window would silently accumulate deviations
  // for as long as the device stayed disconnected and dump a stale "peak"
  // into the first packet after reconnecting.
  if (nowMs - lastTransmitReadMs >= IMU_TRANSMIT_INTERVAL_MS) {
    lastTransmitReadMs += IMU_TRANSMIT_INTERVAL_MS;
    if (nowMs - lastTransmitReadMs >= IMU_TRANSMIT_INTERVAL_MS) {
      lastTransmitReadMs = nowMs; // fell > 1 interval behind - resync
    }

    float accelFiltered[3], gyroFiltered[3];
    for (int i = 0; i < 3; i++) {
      accelFiltered[i] = accelAxes[i].read();
      gyroFiltered[i] = gyroAxes[i].read();
    }

    // LSM6DS3 returns g and deg/s directly, so the protocol conversion is
    // just a scale into milli-g and centi-deg/sec respectively.
    latestUnits.gX = toProtocolInt16(accelFiltered[0] * 1000.0f);
    latestUnits.gY = toProtocolInt16(accelFiltered[1] * 1000.0f);
    latestUnits.gZ = toProtocolInt16(accelFiltered[2] * 1000.0f);
    latestUnits.rX = toProtocolInt16(gyroFiltered[0] * 100.0f);
    latestUnits.rY = toProtocolInt16(gyroFiltered[1] * 100.0f);
    latestUnits.rZ = toProtocolInt16(gyroFiltered[2] * 100.0f);
  }
}

ImuProtocolUnits imuReadProtocolUnits() { return latestUnits; }
