c20d-us/Gnimu/code/Gnimu/src/app/App.h

// Gnimu - GNSS+IMU streaming telemetry
// Copyright (C) 2026 Chris Halstead
// SPDX-License-Identifier: GPL-3.0-or-later

#pragma once

#include "../core/BatteryMonitor.h"
#include "../core/ConfirmWindow.h"
#include "../core/DeviceCommand.h"
#include "../core/GnssFeed.h"
#include "../core/ResetReason.h"
#include "../core/RunStateMachine.h"
#include "../core/Scheduler.h"
#include "../core/StatusLed.h"
#include "../platform/Clock.h"
#include "../peripherals/ble/BleTransport.h"
#include "../peripherals/gnss/Gnss.h"
#include "../peripherals/imu/ImuDevice.h"
#include "SystemConfig.h"
#include "Console.h"
#include "Diagnostics.h"
#include "protocol/Protocol.h"

namespace gnimu {

class App {
 public:
  App();
  void begin();
  void tick();

 private:
  // Job ids: indices into kJobSpecs and the scheduler, in priority order.
  enum : size_t { kGnssJob, kImuJob, kBatteryJob, kPowerJob, kBleJob, kLedJob, kConsoleJob, kJobs };

  void gnssJob();
  void imuJob();
  void batteryJob();
  void powerJob();
  void bleJob();
  void ledJob();
  void consoleJob();
  // One line per job, each naming its id; the constructor checks the table at
  // compile time (id order, names, positive periods).
  static constexpr JobSpec<App> kJobSpecs[kJobs] = {
      {kGnssJob, "gnss", config::kGnssDrainPeriodUs, config::kGnssDrainBudgetUs, &App::gnssJob},
      {kImuJob, "imu", config::kImuSamplePeriodUs, config::kImuSampleBudgetUs, &App::imuJob},
      {kBatteryJob, "battery", config::kBatteryPeriodUs, config::kBatteryBudgetUs, &App::batteryJob},
      {kPowerJob, "power", config::kPowerPeriodUs, config::kPowerBudgetUs, &App::powerJob},
      {kBleJob, "ble", config::kBlePeriodUs, config::kBleBudgetUs, &App::bleJob},
      {kLedJob, "led", config::kLedPeriodUs, config::kLedBudgetUs, &App::ledJob},
      {kConsoleJob, "console", config::kConsolePeriodUs, config::kConsoleBudgetUs, &App::consoleJob},
  };
  // One blocking sampling run (~100 ms) at boot, before the GNSS starts.
  void primeBattery();
  // nullptr on boards without a battery.
  const BatteryStatus* batteryStatus() const;
  // Carries out a state-machine Transition: entering a state sets its jobs and
  // runs its entry effects, following Starting's bring-up result on into Running
  // or Fault. Restart and SystemOff don't return.
  void apply(Transition t);
  // One state's fixed entry effects - the only place peripherals start or
  // stop. Returns the follow-up transition (Starting reports the
  // bring-up result); Stay for the others.
  Transition enter(RunState s);
  void setJobs(const JobSet& j);
  // GNSS, IMU and BLE off in hardware-safe order. Idempotent: safe when
  // nothing was started (a boot straight into waiting).
  void stopPeripherals();
  // Back to RUNNING always goes through a fresh boot: it reruns
  // the verified bring-up instead of restarting peripherals in place. The
  // reason is kept across the reset for the next boot's "Reset:" line.
  [[noreturn]] void restart(RestartReason why);
  [[noreturn]] void enterSystemOff(bool requested);
  // A client's request, from the console or BLE.
  void onCommand(DeviceCommand c);
  // Console G: asks twice, then wipes the receiver and restarts.
  void onGnssReset();
  // Console C: the counters App owns. Diagnostics re-baselines its own rate
  // trackers when it sees the same command.
  void clearStats();

  MemberJobs<App, kJobs> jobs_;
  Scheduler<kJobs, PlatformClock> scheduler_;
  Gnss gnss_;
  ImuDevice imu_;
  BleTransport ble_;
  Console console_;
  char deviceId_[11] = {};  // 10 digits; also the BLE name suffix and DIS serial
  GnssFeed feed_;
  Protocol protocol_;
  CommandFrameParser commandParser_;
  ConfirmWindow confirm_{config::kConfirmWindowMs};
  StatusLed statusLed_;
  BatteryMonitor battery_;
  RunStateMachine machine_;
  uint32_t loops_ = 0;
  ResetRecord reset_ = {};  // set first thing in begin()
  // Last: it references most of the members above.
  Diagnostics diagnostics_;
};

}  // namespace gnimu
