c20d-us/Gnimu/classic/src/Gnimu-ESP32/g_telemetry.cpp

// Gnimu - RaceBox Mini-compatible GNSS+IMU streaming telemetry
// Copyright (C) 2026 Chris Halstead
//
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
#include "g_telemetry.h"
#include "config.h"
#include "g_ble.h"
#include "g_gnss.h"
#include "g_imu.h"
#include "g_imu_trim.h"
#include "g_log.h"
#include "g_ubx_helpers.h"

// Internal counters and a private pointer to the latest PVT data
static unsigned long bootTimeMs = 0;
static unsigned long lastReportMs = 0;
static unsigned int bleSentPacketCount = 0;
static unsigned int gnssEpochCount = 0;
// Rates published by updateRates() at each window close. Always compiled in -
// see telemetryGnssRateHz() in the header for why.
static float gnssRateHz = 0.0f;
static float bleRateHz = 0.0f;
static const UBX_NAV_PVT_data_t *pvt = nullptr;

// Assemble an 88-byte RaceBox Data Message from the latest GNSS + IMU data.
// Fills packet[0..87] with the UBX header, 80-byte payload, and checksum.
// Once packet is built, hand off to BLE to send it.
static void sendPacket() {
  // Defensive check: if we somehow reach here with no data, abort immediately.
  if (pvt == nullptr) {
    return;
  }

  // The 80-byte payload is built in place inside the packet buffer (it
  // occupies bytes 6..85), so no separate staging buffer or copy is needed.
  uint8_t packet[88] = {0};
  uint8_t *payload = packet + 6;

  ImuProtocolUnits imu = imuReadProtocolUnits();

  // Casts pin each field to its RaceBox protocol wire width (U1/U2/U4/I4),
  // so the writeLittleEndian overload is correct regardless of the u-blox
  // library's field types.
  writeLittleEndian(payload, 0, (uint32_t)pvt->iTOW); // U4
  writeLittleEndian(payload, 4, (uint16_t)pvt->year); // U2
  writeLittleEndian(payload, 6, (uint8_t)pvt->month); // U1
  writeLittleEndian(payload, 7, (uint8_t)pvt->day);   // U1
  writeLittleEndian(payload, 8, (uint8_t)pvt->hour);  // U1
  writeLittleEndian(payload, 9, (uint8_t)pvt->min);   // U1
  writeLittleEndian(payload, 10, (uint8_t)pvt->sec);  // U1

  // Offset 11: Validity Flags
  uint8_t validityFlags = 0;
  if (pvt->valid.bits.validDate)
    validityFlags |= (1 << 0); // Bit 0: valid date
  if (pvt->valid.bits.validTime)
    validityFlags |= (1 << 1); // Bit 1: valid time
  if (pvt->valid.bits.fullyResolved)
    validityFlags |= (1 << 2); // Bit 2: fully resolved
  if (pvt->valid.bits.validMag)
    validityFlags |= (1 << 3); // Bit 3: valid magnetic declination
  writeLittleEndian(payload, 11, validityFlags);

  // Offset 12: Time Accuracy
  writeLittleEndian(payload, 12, (uint32_t)pvt->tAcc); // U4

  // Offset 16: Nanoseconds
  writeLittleEndian(payload, 16, (int32_t)pvt->nano); // I4

  // Offset 20: Fix Status
  // Protocol only defines 0 (no fix), 2 (2D fix), 3 (3D fix).
  // Clamp any other u-blox fix types (e.g. 1=DR only, 4=GNSS+DR) to 0 (no fix).
  uint8_t safeFixType =
      (pvt->fixType == 2 || pvt->fixType == 3) ? pvt->fixType : 0;
  writeLittleEndian(payload, 20, safeFixType);

  // Offset 21: Fix Status Flags
  uint8_t fixStatusFlags = 0;

  // Bit 0: valid fix - a 3D fix that the receiver also reports as within its
  // DOP/accuracy masks (gnssFixOK), the strictest read of "valid".
  if (pvt->fixType == 3 && pvt->flags.bits.gnssFixOK) {
    fixStatusFlags |= (1 << 0);
  }

  // Bit 5: valid heading. Read from the SAME PVT snapshot being transmitted
  // (not a library getter), so it can neither block nor describe a different
  // epoch than the rest of this packet.
  if (pvt->flags.bits.headVehValid) {
    fixStatusFlags |= (1 << 5);
  }
  writeLittleEndian(payload, 21, fixStatusFlags);

  // Offset 22: Date/Time Flags
  uint8_t dateTimeFlags = 0;
  if (pvt->valid.bits.validTime)
    dateTimeFlags |= (1 << 5); // Available confirmation of Date/Time Validity
  if (pvt->valid.bits.validDate)
    dateTimeFlags |= (1 << 6); // Confirmed UTC Date Validity
  if (pvt->valid.bits.validTime && pvt->valid.bits.fullyResolved)
    dateTimeFlags |= (1 << 7); // Confirmed UTC Time Validity
  writeLittleEndian(payload, 22, dateTimeFlags);

  // Offset 23: Number of SVs
  writeLittleEndian(payload, 23, (uint8_t)pvt->numSV); // U1

  // Remaining fields, mostly direct mappings from u-blox data
  writeLittleEndian(payload, 24, (int32_t)pvt->lon);      // I4
  writeLittleEndian(payload, 28, (int32_t)pvt->lat);      // I4
  writeLittleEndian(payload, 32, (int32_t)pvt->height);   // I4
  writeLittleEndian(payload, 36, (int32_t)pvt->hMSL);     // I4
  writeLittleEndian(payload, 40, (uint32_t)pvt->hAcc);    // U4
  writeLittleEndian(payload, 44, (uint32_t)pvt->vAcc);    // U4
  writeLittleEndian(payload, 48, (int32_t)pvt->gSpeed);   // I4
  writeLittleEndian(payload, 52, (int32_t)pvt->headMot);  // I4
  writeLittleEndian(payload, 56, (uint32_t)pvt->sAcc);    // U4
  writeLittleEndian(payload, 60, (uint32_t)pvt->headAcc); // U4
  writeLittleEndian(payload, 64, (uint16_t)pvt->pDOP);    // U2

  // Offset 66: Lat/Lon Flags
  uint8_t latLonFlags = 0;
  // Bit 0: invalid latitude, longitude, WGS and MSL altitude. Keyed off the
  // clamped fix type so it always agrees with offset 20.
  if (safeFixType == 0) {
    latLonFlags |= (1 << 0);
  }
  writeLittleEndian(payload, 66, latLonFlags);

  // Offset 67: Battery status (1 byte) - bit 7 = charging, bits 0-6 = percent.
  // No battery on this build: always 100%, not charging.
  writeLittleEndian(payload, 67, (uint8_t)100);

  // Offset 68-78: IMU data
  writeLittleEndian(payload, 68, imu.gX);
  writeLittleEndian(payload, 70, imu.gY);
  writeLittleEndian(payload, 72, imu.gZ);
  writeLittleEndian(payload, 74, imu.rX);
  writeLittleEndian(payload, 76, imu.rY);
  writeLittleEndian(payload, 78, imu.rZ);

  // Add RaceBox protocol header
  packet[0] = 0xB5;
  packet[1] = 0x62;
  packet[2] = 0xFF; // Message Class: RaceBox Data Message
  packet[3] = 0x01; // Message ID: RaceBox Data Message
  packet[4] = 80;   // Payload size
  packet[5] = 0;

  // Calculate payload checksum and add to packet
  UbxChecksum checksum = calculateChecksum(payload, 80, 0xFF, 0x01);
  packet[86] = checksum.ckA;
  packet[87] = checksum.ckB;

  // Hand the packet off to BLE
  if (bleSendPacket(packet, 88)) {
    bleSentPacketCount++;
  }
}

// Close the stats window: convert the epoch/packet counts accumulated since
// the last window into rates, publish them, and reset the counters.
static void updateRates(unsigned long now) {
  const float elapsed = (now - lastReportMs) / 1000.0f;
  if (elapsed <= 0.0f) {
    return;
  }
  gnssRateHz = gnssEpochCount / elapsed;
  bleRateHz = bleSentPacketCount / elapsed;
  gnssEpochCount = 0;
  bleSentPacketCount = 0;
  lastReportMs = now;
}

float telemetryGnssRateHz() { return gnssRateHz; }
float telemetryBleRateHz() { return bleRateHz; }

// Periodically print packet rate and GNSS/IMU debug stats over serial.
// Called only when a stats window has just closed, so it does no timing of its
// own - it reads the rates updateRates() has already published.
static void telemetrySerialReport(unsigned long now) {
  (void)now; // only read by the report body, which silent builds compile out
#if LOG_ENABLED
  {
    const float bleRate = telemetryBleRateHz();
    const float gnssRate = telemetryGnssRateHz();
    // Additional satellite info for debugging: number of satellites, fix type,
    // horizontal accuracy, and lat/lon
    uint8_t sats = 0, fix = 0;
    uint32_t hAcc = 0, tAcc = 0;
    double lat = 0.0, lon = 0.0;
    if (pvt != nullptr) {
      sats = pvt->numSV;
      fix = pvt->fixType;
      hAcc = pvt->hAcc;
      tAcc = pvt->tAcc;
      lat = pvt->lat * 1e-7;
      lon = pvt->lon * 1e-7;
    }
    // Convert filtered IMU values to protocol units for display
    ImuProtocolUnits imu = imuReadProtocolUnits();

    // Runtime trim state, three-way. The angle is the MEASURED tilt and is
    // reported even when it exceeded IMU_TRIM_MAX_TILT_DEG and the rotation was
    // refused - that is the case worth seeing on the console, so it must
    // survive the refusal.
    //
    //   ✅  locked
    //   ❌  measured a mount too far off level to correct; never converges
    //   ⏳  still deciding - either no stationary window has closed yet
    //       (tiltDegrees() reads 0 until the first block, so a badly mounted
    //       device shows ⏳ for ~11s before the ❌), or a correctable mount
    //       that has not converged
    //
    // Same policy as the OLED status-bar indicator, and the same collapse of
    // docs/imu-trim-design.md section 9's tiers onto one threshold. On the two
    // variants with no panel this line is the ONLY trim indicator.
    const float trimTilt = imuTrimTiltDegrees();
    const char *trimState = imuTrimConverged()                   ? "✅"
                            : (trimTilt > IMU_TRIM_MAX_TILT_DEG) ? "❌"
                                                                 : "⏳";

    LOG_PRINTF(
        "RT: %us | BLE: %.0fHz | GNSS: %.0fHz | SV: %u | Fix: %u | tAcc: "
        "%uns | hAcc: %umm | Lat: %.7f | Lon: %.7f | mG: X=%d Y=%d Z=%d | "
        "c°/s: X=%d Y=%d Z=%d | Trim: %.1f° %s\n",
        (unsigned int)((now - bootTimeMs) / 1000), bleRate, gnssRate, sats, fix,
        (unsigned int)tAcc, (unsigned int)hAcc, lat, lon, imu.gX, imu.gY,
        imu.gZ, imu.rX, imu.rY, imu.rZ, trimTilt, trimState);
    // Counters and the window timestamp are reset by updateRates(), which runs
    // whether or not this report is compiled in.
  }
#endif // LOG_ENABLED
}

// Simple startup - just prime the boot time and report timer.
void telemetryBegin() { bootTimeMs = lastReportMs = millis(); }

// On each new GNSS epoch, count it and (when connected) send a packet.
// Always try to send informational report over serial.
void telemetrySendIfReady() {
  if (const UBX_NAV_PVT_data_t *newPvt = gnssConsumePvt()) {
    pvt = newPvt;
    gnssEpochCount++;
    if (bleIsConnected()) {
      sendPacket();
    }
  }

  // Close the stats window on schedule. updateRates() is unconditional so the
  // rates stay available in silent builds; only the printing is compiled out.
  const unsigned long now = millis();
  if ((now - lastReportMs) >= LOG_STATS_INTERVAL_MS) {
    updateRates(now);
    telemetrySerialReport(now);
  }
}
