c20d-us/Gnimu/classic/src/Gnimu-nRF52840-OLED/g_ble.cpp

// Gnimu - RaceBox Mini-compatible GNSS+IMU streaming telemetry
// Copyright (C) 2026 Chris Halstead
//
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
#include "g_ble.h"
#include "config.h"
#include "g_battery.h"
#include "g_log.h"
#include <bluefruit.h>

// BLE state - private to this file
// Adjacent string literals concatenate at compile time - no heap, no
// static-init-order concerns.
static const char deviceName[] = RACEBOX_MODEL " " DEVICE_ID;

// Nordic UART Service. Its UUIDs are exactly the RaceBox service/Tx/Rx UUIDs
// (RACEBOX_*_UUID in config.h), so BLEUart implements the RaceBox transport
// natively. Tx = notify, Rx = write.
static BLEUart bleuart;
static BLEDis bledis; // Device Information Service (0x180A)
static BLEBas blebas; // Battery Service (0x180F)

static volatile bool deviceConnected = false;
static uint8_t lastBasPercent = 0xFF; // force a first Battery-service write

// Tracks whether bleBegin() has completed successfully. bleStop() is a no-op
// unless this is true - guards against calling Bluefruit APIs on an
// uninitialized stack (e.g. from a boot-classified quiet state where
// bleBegin was never invoked).
static bool bleInitialized = false;

// Connection callbacks
static void connectCallback(uint16_t conn_handle) {
  (void)conn_handle;
  deviceConnected = true;
  // Switch to the connected TX power level (see BLE_TX_POWER_* in config.h).
  Bluefruit.setTxPower(BLE_TX_POWER_CONN_DBM);
  LOG_PRINTLN("🤝 BLE Client connected");
}

static void disconnectCallback(uint16_t conn_handle, uint8_t reason) {
  (void)conn_handle;
  deviceConnected = false;
  // Restore advertising TX power; advertising auto-restarts.
  Bluefruit.setTxPower(BLE_TX_POWER_ADV_DBM);
  LOG_PRINTF("👋 BLE Client disconnected (reason 0x%02X)\n", reason);
  (void)reason; // only read by the log line, which silent builds compile out
}

static void startAdvertising() {
  Bluefruit.Advertising.addFlags(BLE_GAP_ADV_FLAGS_LE_ONLY_GENERAL_DISC_MODE);
  Bluefruit.Advertising.addTxPower();
  // Advertise the Nordic UART (RaceBox) service so apps can discover us by it.
  Bluefruit.Advertising.addService(bleuart);
  // Full device name goes in the scan response (the 128-bit UUID above nearly
  // fills the 31-byte advertising packet). DIS is found after connect.
  Bluefruit.ScanResponse.addName();

  Bluefruit.Advertising.restartOnDisconnect(true);
  Bluefruit.Advertising.setInterval(32, 244); // fast, slow (units of 0.625 ms)
  Bluefruit.Advertising.setFastTimeout(30);   // seconds in fast mode
  Bluefruit.Advertising.start(0);             // 0 = advertise without timeout
  LOG_PRINTLN("📡 BLE advertising started.");
}

void bleBegin() {
  // Raise the ATT MTU ceiling so an 88-byte notify fits in one packet.
  // Must be called BEFORE Bluefruit.begin() to take effect.
  Bluefruit.configPrphBandwidth(BANDWIDTH_MAX);

  Bluefruit.begin(); // 1 peripheral, 0 central (defaults)
  Bluefruit.setName(deviceName);
  Bluefruit.setTxPower(BLE_TX_POWER_ADV_DBM);
  LOG_PRINTF("✅ BLE TX power set to %d dBm (advertising).\n",
             BLE_TX_POWER_ADV_DBM);
  // g_led owns the RGB LED; stop Bluefruit toggling the onboard LED itself.
  Bluefruit.autoConnLed(false);
  Bluefruit.Periph.setConnectCallback(connectCallback);
  Bluefruit.Periph.setDisconnectCallback(disconnectCallback);

  // Device Information Service
  bledis.setManufacturer(RACEBOX_MANUFACTURER);
  bledis.setModel(RACEBOX_MODEL);
  bledis.setSerialNum(DEVICE_ID);
  bledis.setFirmwareRev(RACEBOX_FIRMWARE_VERSION);
  bledis.setHardwareRev(RACEBOX_HARDWARE_VERSION);
  bledis.begin();

  // Battery Service (reflects the real cell state of charge)
  blebas.begin();
  blebas.write(batteryGetStatus().percent);

  // Nordic UART / RaceBox service. Rx exists for the RaceBox GATT layout;
  // writes to it are accepted and ignored.
  bleuart.begin();

  startAdvertising();

  bleInitialized = true;
}

bool bleIsConnected() { return deviceConnected; }

void bleSendPacket(uint8_t *data, size_t len) {
  // Notifies the Tx characteristic. If the MTU is smaller than len, BLEUart
  // splits it across notifications; the RaceBox app reassembles the UBX stream.
  bleuart.write(data, len);
}

void bleUpdate() {
  // Keep the Battery service in step with the cell, but only on a real change
  // (avoids a needless notify every loop). LED lives in g_led now.
  const uint8_t pct = batteryGetStatus().percent;
  if (pct != lastBasPercent) {
    blebas.write(pct);
    lastBasPercent = pct;
  }
}

void bleStop() {
  // No-op if the stack was never brought up (e.g. boot classifier landed in
  // a quiet state and bleBegin never ran).
  if (!bleInitialized) {
    return;
  }
  // Turn OFF restart-on-disconnect FIRST. Otherwise Bluefruit's internal
  // disconnect handler (triggered by our disconnect() calls below) fires
  // Advertising.start() before - or racing with - our own Advertising.stop(),
  // and the device stays advertising even though we asked it to hush.
  Bluefruit.Advertising.restartOnDisconnect(false);

  // Disconnect any active peripheral connection so the client sees a clean
  // link end rather than a silent, indefinitely-hanging one. Bluefruit's
  // BLE_MAX_CONNECTION is the compile-time upper bound; only handle 0 is
  // ever populated in our peripheral-only config, but iterating costs
  // nothing and future-proofs against a bandwidth-config change.
  for (uint16_t h = 0; h < BLE_MAX_CONNECTION; h++) {
    BLEConnection *c = Bluefruit.Connection(h);
    if (c && c->connected()) {
      c->disconnect();
    }
  }
  // Vanish from BLE scans.
  Bluefruit.Advertising.stop();
  LOG_PRINTLN("📴 BLE stopped (disconnected + advertising off).");
}
