c20d-us/Gnimu/src/Gnimu-nRF52840-OLED/g_power.cpp

// Gnimu - RaceBox Mini-compatible GNSS+IMU streaming telemetry
// Copyright (C) 2026 Chris Halstead
//
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
#include "g_power.h"
#include "config.h"
#include "g_log.h"

// Drive the GNSS TPS63020 EN pin to its "disabled" level. Must be OUTPUT for
// the write to take effect. An INPUT pin lets the TPS's own EN pullup win.
static void gnssEnDisable() {
  pinMode(GNSS_EN_PIN, OUTPUT);
  digitalWrite(GNSS_EN_PIN, LOW); // active-high enable, so LOW disables
}

// Idle GNSS TX (D6) low as a GPIO. If Serial1 is left running, D6 idles HIGH
// and leaks through the GNSS RX ESD diode into VCC. We don't own Serial1 here,
// so we just claim the pin as GPIO. Callers that had Serial1 up must
// Serial1.end() before us.
static void gnssTxIdleLow() {
  pinMode(GNSS_TX_PIN, OUTPUT);
  digitalWrite(GNSS_TX_PIN, LOW);
}

// Turn the RGB LED off via direct pin drives (active-low: HIGH = off). Used
// before g_led has initialized, and as the final word before DEEP_SLEEP's
// permanent halt.
static void ledPinsOff() {
  pinMode(LED_RED_PIN, OUTPUT);
  pinMode(LED_GREEN_PIN, OUTPUT);
  pinMode(LED_BLUE_PIN, OUTPUT);
  digitalWrite(LED_RED_PIN, HIGH);
  digitalWrite(LED_GREEN_PIN, HIGH);
  digitalWrite(LED_BLUE_PIN, HIGH);
}

// Switch-sense cache - refreshed every POWER_SWITCH_POLL_INTERVAL_MS
// (config.h).
static bool switchOnCached = true; // optimistic default until powerBegin runs
static unsigned long switchLastPollMs = 0;

// Switch-sense: one analogRead per throttled call.
static bool switchReadOnce() {
  const float adcMax = (float)((1UL << SAADC_RESOLUTION_BITS) - 1);
  const int mv = (int)(((float)analogRead(POWER_SWITCH_SENSE_PIN) / adcMax) *
                           SAADC_REFERENCE_MV +
                       0.5f);
  return mv < POWER_SWITCH_OFF_THRESHOLD_MV;
}

// Initialize power management: analogRead resolution, reference, sample time,
// and switch-sense pin mode. Also primes the switch state cache.
void powerBegin() {
  analogReadResolution(SAADC_RESOLUTION_BITS);
  analogReference(AR_INTERNAL_3_0); // pairs with SAADC_REFERENCE_MV == 3000
  analogSampleTime(SAADC_TACQ_US);  // long TACQ for the high-Z divider

  pinMode(POWER_SWITCH_SENSE_PIN, INPUT);

  // Prime the cached reading synchronously so stateBegin() gets an
  // authoritative switch position on its very first powerSwitchOn() call.
  // One-time cost.
  switchOnCached = switchReadOnce();
  switchLastPollMs = millis();
}

// Detect whether we're plugged into USB.
bool powerUsbPresent() {
  return (NRF_POWER->USBREGSTATUS & POWER_USBREGSTATUS_VBUSDETECT_Msk) != 0;
}

// Return true if the power switch is on (battery is physically in the circuit).
bool powerSwitchOn() {
  const unsigned long nowMs = millis();
  if ((nowMs - switchLastPollMs) >= POWER_SWITCH_POLL_INTERVAL_MS) {
    switchLastPollMs = nowMs;
    switchOnCached = switchReadOnce();
  }
  return switchOnCached;
}

// Disable all peripherals.
void powerHoldPeripheralsOff() {
  gnssEnDisable();
  gnssTxIdleLow();
  pinMode(IMU_POWER_PIN, OUTPUT);
  digitalWrite(IMU_POWER_PIN, LOW);
  ledPinsOff();
}

// Restore power to the GNSS rail.
void powerGnssRailOn() {
  // Release EN to INPUT (hi-Z). The TPS63020's own EN pullup then drives it
  // high and the rail comes up.
  pinMode(GNSS_EN_PIN, INPUT);
}

// Disable power to the GNSS rail.
void powerGnssRailOff() {
  // Drive EN low to disable the TPS63020 rail.
  gnssEnDisable();
  gnssTxIdleLow();
}

// Enter deep sleep mode, disabling all peripherals and powering down the
// system. Does not return.
void powerEnterDeepSleep() {
  LOG_PRINTLN("💤 Entering deep sleep (System OFF).");
  LOG_FLUSH();
  // Hold everything off - GPIO state persists through System OFF, so anything
  // left driven will keep drawing until the reset.
  powerHoldPeripheralsOff();
  // Reached both before bleBegin() (a low-voltage boot) and after. With the
  // SoftDevice enabled, System OFF must go through it; without it, that call
  // returns an error and the register is written directly, as the core's
  // systemOff() does.
  uint8_t sdEnabled = 0;
  (void)sd_softdevice_is_enabled(&sdEnabled);
  if (sdEnabled) {
    sd_power_system_off();
  } else {
    NRF_POWER->SYSTEMOFF = 1;
  }
  while (1) {
    delay(100); // only reached under a debugger
  }
}
