c20d-us/Gnimu/code/Gnimu/src/app/Diagnostics.h

// Gnimu - GNSS+IMU streaming telemetry
// Copyright (C) 2026 Chris Halstead
// SPDX-License-Identifier: GPL-3.0-or-later

#pragma once

#include <stddef.h>
#include <stdint.h>

#include "../core/BatteryMonitor.h"
#include "../core/GnssFeed.h"
#include "../core/RateTracker.h"
#include "../core/ResetReason.h"
#include "../core/RunStateMachine.h"
#include "../core/Scheduler.h"
#include "../core/TextOut.h"
#include "../peripherals/ble/BleTransport.h"
#include "../peripherals/gnss/Gnss.h"
#include "../peripherals/imu/ImuDevice.h"
#include "Console.h"

namespace gnimu {

// The console's reporting side: the D report, the 1 s status line, and the
// V lines (build, device ID, the receiver's clock and the build's settings). It only reads the modules it reports on; App
// routes each command, clears its own state on Clear, and passes every command
// here too, so each owner resets only what it owns.
class Diagnostics {
 public:
  // Everything is referenced, not copied, and must outlive this object.
  // `battery` is nullptr on boards without one.
  Diagnostics(Console& console, const Job* jobs, const JobStats* stats, size_t jobCount,
              const uint32_t& loops, const GnssFeed& feed, const Gnss& gnss, const ImuDevice& imu,
              const BleTransport& ble, const BatteryStatus* battery,
              const RunStateMachine& machine, const char* deviceId, const ResetRecord& reset)
      : console_(console),
        jobs_(jobs),
        stats_(stats),
        jobCount_(jobCount),
        loops_(loops),
        feed_(feed),
        gnss_(gnss),
        imu_(imu),
        ble_(ble),
        battery_(battery),
        machine_(machine),
        deviceId_(deviceId),
        reset_(reset) {}

  // One poll's result: Report, Version, ToggleStatus and a count act here;
  // Clear re-baselines the status line's rate trackers (App clears the
  // counters themselves first).
  void handle(const ConsoleCommand& cmd);
  // Prints the status line when one is due.
  void tick(uint64_t nowUs);

  // What this device is: the build, the device ID, the receiver's CPU clock
  // once it has been read, and the settings the build was compiled with. The V
  // command, and the top of the boot log, which prints before the clock is read.
  void printVersion();
  // The same text for `buf`, lines separated by '\n'; truncated, never
  // overrun. What a BLE client reads from the config characteristic. Returns
  // the length.
  size_t formatVersion(char* buf, size_t cap) const;

 private:
  // Arms (or disarms, with count == 0) periodic status reporting and resets
  // the rate trackers' baseline so the first line's Hz reflects only the
  // interval after arming, not however long events have been accumulating.
  void armStatus(uint32_t count);
  // One "Config:" line per group of settings. They are compile-time values,
  // shown so a device can be asked what it was built with.
  void putConfig(detail::Out& o) const;
  // The device's state now, for the D report and the status line alike.
  DeviceStatus snapshot(uint64_t nowUs) const;
  void printReport();
  void printStatus(uint64_t nowUs);

  Console& console_;
  const Job* jobs_;
  const JobStats* stats_;
  size_t jobCount_;
  const uint32_t& loops_;
  const GnssFeed& feed_;
  const Gnss& gnss_;
  const ImuDevice& imu_;
  const BleTransport& ble_;
  const BatteryStatus* battery_;
  const RunStateMachine& machine_;
  const char* deviceId_;
  const ResetRecord& reset_;

  RateTracker gnssRate_;  // status line: epochs/s
  RateTracker bleRate_;   // status line: packets sent/s
  // Status lines still to print: 0 = off. Both L and a typed count arm it,
  // never beyond kStatusMaxCount.
  uint32_t statusRemaining_ = 0;
  uint64_t nextStatusDueUs_ = 0;
};

}  // namespace gnimu
