c20d-us/Gnimu/src/Gnimu-nRF52840-OLED/g_gnss.h

// Gnimu - RaceBox Mini-compatible GNSS+IMU streaming telemetry
// Copyright (C) 2026 Chris Halstead
// Based on the Open-Source RaceBox Mini Emulator by Anchit Chandra Sekhar
// (https://github.com/anchit92/Open-Source-RaceBox-mini-Emulator)
//
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
#pragma once
#include <Arduino.h>
#include <SparkFun_u-blox_GNSS_v3.h>

// ============================================================================
// GNSS module - u-blox receiver on Serial1 (XIAO D6=TX / D7=RX)
//
// Owns the receiver object and its serial port internally.
// Callers interact only through the small read-only interface below.
// ============================================================================

// Bring up the receiver and configure the GNSS.
// False if the module is not detected; the caller hands that to
// stateGnssFailed().
bool gnssBegin();

// Release Serial1 so its pins (D6/D7) revert to plain GPIO and can be idled
// low by powerHoldPeripheralsOff(). MUST be called before the state machine
// enters BATTERY_WAIT or DEEP_SLEEP from RUNNING, otherwise the UART
// peripheral keeps owning D6 and idles it HIGH, phantom-powering the GNSS
// through its RX ESD diode even with the TPS rail cut.
void gnssEnd();

// Pumps the GNSS UART and triggers a callback if a new epoch has arrived.
// Sets the appropriate navigation frequency based on the current state.
// Call every loop().
void gnssPoll();

// Fetches a pointer to the most recent PVT data.
// Returns a valid pointer to the PVT if a new epoch has arrived since the last
// call, otherwise returns nullptr.
const UBX_NAV_PVT_data_t *gnssConsumePvt();

// Peek at the most recent PVT WITHOUT consuming it. Returns nullptr until the
// first epoch has ever arrived; afterwards it always returns the last one,
// however stale.
//
// gnssConsumePvt() is consume-once by design - it clears the new-epoch flag on
// the way out, so exactly one caller can ever see a given epoch, and that
// caller is g_telemetry. Any second consumer calling it would race: whichever
// ran first in a loop iteration takes the epoch and the other sees nullptr,
// producing dropped BLE packets or a half-rate reader depending on call order.
// Read-only observers (a display, a health check) must use this instead.
//
// Staleness is the caller's problem: this says nothing about how old the data
// is, or whether the receiver is even powered - in LIGHT_SLEEP or after an
// EN-cut the last epoch simply stops advancing.
const UBX_NAV_PVT_data_t *gnssLatestPvt();

// Put the receiver into RXM-PMREQ backup mode (LIGHT_SLEEP entry): rail
// stays on, ~uA draw, BBR/ephemeris retained.
void gnssSleep();

// Wake the receiver from gnssSleep() via a manual GPIO pulse on the shared
// UART line. The receiver resumes its prior config (AutoPVT etc.) on its
// own. Only valid if the receiver is still in backup mode (i.e. not after
// a full EN-cut - that needs powerGnssRailOn() + gnssBegin() instead).
void gnssWake();
