c20d-us/Gnimu/tools/gnss_otp_clock/gnss_otp_clock.ino

// Gnimu - GNSS+IMU streaming telemetry
// Copyright (C) 2026 Chris Halstead
// SPDX-License-Identifier: GPL-3.0-or-later

// ============================================================================
// TOOL: program the u-blox M10 high-performance CPU clock into OTP
//
// *** THIS MAKES A PERMANENT, IRREVERSIBLE CHANGE TO THE RECEIVER. ***
//
// u-blox ships M10 silicon at a reduced CPU clock to save power. At that stock
// clock the maximum navigation update rate is the "Default" row below; the row
// every M10 spec sheet quotes is the "High" one, and the datasheets footnote it
// as "Configuration required":
//
//   Constellations enabled        1       2       3       4
//   ---------------------------------------------------------
//   Default CPU clock          18 Hz   10 Hz   10 Hz    5 Hz
//   High CPU clock             25 Hz   20 Hz   16 Hz   10 Hz
//
// The configuration in question is a one-time write of a higher CPU clock rate
// into the receiver's OTP (one-time programmable) memory, per MAX-M10S
// Integration manual UBX-20053088 sec 2.1.7. It moves three clocks from 128 to
// 192 MHz and one from 64 to 96 MHz, costs 18 of the receiver's 64 bytes of OTP
// space, and CANNOT BE UNDONE. Read `gnss_ver`'s output before running this,
// and test burn a spare module first if you have one.
//
// This sketch follows the manual's procedure exactly:
//
//   1. Connect, silence the receiver's periodic output, and poll UBX-MON-VER
//      (the manual's own interface check).
//   2. Read the four clock keys back - from RAM, from the firmware Default
//      layer, and from OTP layer 4, which is what the manual's verification
//      step polls.
//   3. If the high clock is ALREADY programmed: report and halt. No write.
//      If the receiver doesn't look like an M10 at the stock clock: report and
//      halt. No write. The write only happens on the exact case it is for.
//   4. Otherwise, wait for the operator to type the confirmation word. Any
//      other input aborts.
//   5. Send the two UBX-CFG (0x06 0x41) frames from Table 8 and check for the
//      two ACK-ACKs the manual specifies.
//   6. Hardware-reset the receiver so the new clock is applied at startup.
//   7. Re-connect and re-read all three layers, comparing the OTP-layer reply
//      byte-for-byte against the frame the manual says to expect.
//
// Every byte string below was checked against the manual and its UBX checksums
// recomputed independently before being pasted here.
//
// A NOTE ON QUIETING THE RECEIVER
//
// The sketch silences periodic output before doing anything else. The reason is
// narrow: there is exactly one window where it cannot drain the UART, and that
// is the blocking wait for the operator to type the confirmation word, which
// lasts as long as they take to read the warning. A Gnimu-configured receiver
// pushes ~2 KB/s, so a 64-byte RX ring (the nRF52 core's compile-time size)
// overflows in about 30 ms of wait. The overflow is not itself fatal,
// since the buffer is drained before the write, but a UART left in an overrun
// state is not what anyone wants immediately before an irreversible operation.
//
// Quieting also means the ACK and VALGET replies arrive in an otherwise empty
// stream, so the frame scanner never has to resync past unrelated traffic.
//
// See quietReceiver() for what is turned off and why UBX output has to stay on.
//
// A NOTE ON THE RESET
//
// The manual says to power-cycle or send UBX-CFG-RST. This sketch sends its own
// CFG-RST with navBbrMask = 0x0000 (hot start) rather than calling the SparkFun
// library's hardReset(), which uses 0xFFFF and would additionally wipe BBR,
// discarding ephemeris for a cold-start TTFF and dropping the saved baud rate.
// Neither is needed to apply an OTP setting: OTP is read at startup regardless.
// resetMode is 0x00, the hardware (watchdog) reset the manual asks for.
//
// The receiver does not ACK CFG-RST, but reset immediately, so the sketch
// re-sweeps the baud rates afterwards rather than assuming the link survived.
//
// PASS CRITERIA
//
// The OTP-layer reply matches the manual's expected frame byte-for-byte. That
// is the manual's own verification step and the authoritative result. The
// Default layer follows it to 192/192/192/96; the RAM layer does NOT, and can
// keep reporting the stock 128/128/128/64 after a fully successful write, so
// RAM must not be used to judge the outcome. If RAM still reads stock after the
// receiver has lost all power, a stock value stored in BBR or flash is
// overriding the OTP clock: G in the firmware's console, or tools/gnss_reset,
// clears it.
//
// Requires: the GNSS wired as the board's build guide describes, USB for
// serial, and the SparkFun_u-blox_GNSS_v3 library installed. Open the serial
// monitor at 115200 with a newline-sending line ending.
// ============================================================================

// UBX-MON-VER can return up to ~348 bytes. Must be defined before the library
// header so the config packet buffer is sized to hold a full reply.
#define MAX_PAYLOAD_SIZE 384

#include <Arduino.h>

// --- Platform wiring -------------------------------------------------------
// The only architecture-dependent part of this sketch: which UART object the
// receiver hangs off, and whether opening it needs pin arguments.
#if defined(ARDUINO_ARCH_ESP32)

// ESP32: UART2 on the GPIOs the Gnimu firmware uses. Change these to match
// your wiring if you routed the receiver elsewhere.
static const int GNSS_RX_PIN = 16; // ESP32 RX <- GNSS TX
static const int GNSS_TX_PIN = 17; // ESP32 TX -> GNSS RX
static HardwareSerial gnssSerial(2);
// A larger RX ring buys slack for the one place this sketch can't drain the
// port: the blocking wait for the operator's confirmation. Must be called
// before begin(). The nRF52 core has no equivalent - its buffer is a
// compile-time constant - which is the other reason the receiver gets quieted
// rather than this being relied on.
#define GNSS_SERIAL_PREPARE() gnssSerial.setRxBufferSize(1024)
#define GNSS_SERIAL_BEGIN(baud)                                                \
  gnssSerial.begin((baud), SERIAL_8N1, GNSS_RX_PIN, GNSS_TX_PIN)

#else

// XIAO nRF52840: Serial (USB CDC) needs the TinyUSB library linked,
// and this sketch pulls in nothing else that would include it transitively.
#include <Adafruit_TinyUSB.h>

// Serial1 = D6 (TX) / D7 (RX), fixed on the nRF52.
static Uart &gnssSerial = Serial1;
#define GNSS_SERIAL_PREPARE() ((void)0)
#define GNSS_SERIAL_BEGIN(baud) gnssSerial.begin(baud)

#endif

#include <SparkFun_u-blox_GNSS_v3.h>

static SFE_UBLOX_GNSS_SERIAL myGNSS;

// The word the operator must type to authorize the burn. Anything else aborts.
static const char CONFIRM_WORD[] = "BURN";

// Common u-blox baud rates. 115200 first (the rate the Gnimu firmware runs
// the receiver at), then the factory default, then the rest.
static const uint32_t BAUD_RATES[] = {115200, 38400,  9600,
                                      57600,  230400, 460800};
static const int NUM_BAUD_RATES = sizeof(BAUD_RATES) / sizeof(BAUD_RATES[0]);

// --- Byte strings from MAX-M10S Integration manual UBX-20053088 sec 2.1.7 ---

// Table 8, "High CPU clock". Two UBX-CFG frames, class 0x06 id 0x41 - an
// undocumented message the SparkFun library has no support for, so these go out
// as raw bytes.
static const uint8_t OTP_WRITE_FRAME_1[] = {
    0xB5, 0x62, 0x06, 0x41, 0x10, 0x00, 0x03, 0x00, 0x04, 0x1F, 0x54, 0x5E,
    0x79, 0xBF, 0x28, 0xEF, 0x12, 0x05, 0xFD, 0xFF, 0xFF, 0xFF, 0x8F, 0x0D};
static const uint8_t OTP_WRITE_FRAME_2[] = {
    0xB5, 0x62, 0x06, 0x41, 0x1C, 0x00, 0x04, 0x01, 0xA4, 0x10, 0xBD, 0x34,
    0xF9, 0x12, 0x28, 0xEF, 0x12, 0x05, 0x05, 0x00, 0xA4, 0x40, 0x00, 0xB0,
    0x71, 0x0B, 0x0A, 0x00, 0xA4, 0x40, 0x00, 0xD8, 0xB8, 0x05, 0xDE, 0xAE};

// Step 5's verification poll: UBX-CFG-VALGET, layer 4 (OTP), the four clock
// keys.
static const uint8_t OTP_VERIFY_POLL[] = {
    0xB5, 0x62, 0x06, 0x8B, 0x14, 0x00, 0x00, 0x04, 0x00, 0x00,
    0x01, 0x00, 0xA4, 0x40, 0x03, 0x00, 0xA4, 0x40, 0x05, 0x00,
    0xA4, 0x40, 0x0A, 0x00, 0xA4, 0x40, 0x4C, 0x15};

// The reply the manual says a correctly programmed receiver returns. Compared
// byte-for-byte after the burn.
static const uint8_t OTP_VERIFY_EXPECTED[] = {
    0xB5, 0x62, 0x06, 0x8B, 0x24, 0x00, 0x01, 0x04, 0x00, 0x00, 0x01,
    0x00, 0xA4, 0x40, 0x00, 0xB0, 0x71, 0x0B, 0x03, 0x00, 0xA4, 0x40,
    0x00, 0xB0, 0x71, 0x0B, 0x05, 0x00, 0xA4, 0x40, 0x00, 0xB0, 0x71,
    0x0B, 0x0A, 0x00, 0xA4, 0x40, 0x00, 0xD8, 0xB8, 0x05, 0x76, 0x81};

// UBX-CFG-RST, navBbrMask 0x0000 (hot start), resetMode 0x00 (hardware reset).
// See the header for why this rather than the library's hardReset().
static const uint8_t CFG_RST_HARDWARE[] = {0xB5, 0x62, 0x06, 0x04, 0x04, 0x00,
                                           0x00, 0x00, 0x00, 0x00, 0x0E, 0x64};

// --- The four clock keys ---------------------------------------------------
struct ClockKey {
  uint32_t key;
  uint32_t stockHz;
  uint32_t highHz;
};
static const ClockKey CLOCK_KEYS[] = {
    {0x40A40001UL, 128000000UL, 192000000UL},
    {0x40A40003UL, 128000000UL, 192000000UL},
    {0x40A40005UL, 128000000UL, 192000000UL},
    {0x40A4000AUL, 64000000UL, 96000000UL},
};
static const int NUM_CLOCK_KEYS = sizeof(CLOCK_KEYS) / sizeof(CLOCK_KEYS[0]);

// What the RAM layer says the receiver is running.
enum ClockState { CLOCK_HIGH, CLOCK_STOCK, CLOCK_UNKNOWN };

// --- Raw UBX helpers -------------------------------------------------------
// quietReceiver() silences the periodic stream first, but these still parse
// the byte stream into whole frames rather than pattern-matching a buffer:
// quieting is best-effort (an unexpected message may not be in the list), and
// the scanner has to be right whether or not it worked.

static void drainSerial() {
  while (gnssSerial.available()) {
    gnssSerial.read();
  }
}

static void sendRaw(const uint8_t *frame, size_t len) {
  gnssSerial.write(frame, len);
  gnssSerial.flush();
}

// Discard everything arriving for windowMs, then clear the buffer.
//
// This exists because of a specific hazard. A UBX-CFG-VALGET poll is answered
// by the reply frame AND a UBX-ACK-ACK for class/id 0x06 0x8B. The SparkFun
// library's own getVal() is *also* UBX-CFG-VALGET - the same 0x06 0x8B - so a
// leftover ACK from a hand-rolled poll looks exactly like the acknowledgement
// of the library's next request. The library accepts it, returns the response
// already sitting in its buffer, and from then on every read comes back one
// key behind: phase 4 reports a failed CFG-RATE read, constellations and
// message rates all shift by one entry, and the numbers look plausible enough
// to be believed. Consume the ACK before handing the port back.
static void settleAndDrain(uint32_t windowMs) {
  uint32_t deadline = millis() + windowMs;
  while ((int32_t)(millis() - deadline) < 0) {
    while (gnssSerial.available()) {
      gnssSerial.read();
    }
    delay(1);
  }
}

// Read UBX frames until one matches cls/id or the timeout expires. On a match,
// copies the whole frame (sync bytes through checksum) into out and sets
// outLen. Frames failing their checksum are discarded and the scan continues.
static bool waitForUbxFrame(uint8_t cls, uint8_t id, uint8_t *out,
                            size_t maxLen, size_t *outLen, uint32_t timeoutMs) {
  uint32_t deadline = millis() + timeoutMs;

  // Rolling sync byte, so a 0xB5 that turns out not to be followed by 0x62 can
  // itself be the start of the real frame on the next byte. A payload byte can
  // be 0xB5, and this is a one-shot irreversible tool - a scanner that resyncs
  // sloppily could miss the one reply that matters.
  uint8_t prev = 0;

  while ((int32_t)(millis() - deadline) < 0) {
    if (!gnssSerial.available()) {
      delay(1);
      continue;
    }

    uint8_t current = (uint8_t)gnssSerial.read();
    if (!(prev == 0xB5 && current == 0x62)) {
      prev = current;
      continue;
    }
    prev = 0; // consumed the sync pair

    // Header: class, id, length.
    uint8_t header[4];
    for (int i = 0; i < 4; i++) {
      while (!gnssSerial.available() && (int32_t)(millis() - deadline) < 0) {
        delay(1);
      }
      if (!gnssSerial.available()) {
        return false; // timed out mid-frame
      }
      header[i] = gnssSerial.read();
    }

    uint16_t payloadLen = (uint16_t)header[2] | ((uint16_t)header[3] << 8);
    size_t frameLen = 8 + payloadLen;
    if (frameLen > maxLen) {
      // Too big to be the frame we want. Consume and discard it rather than
      // resyncing inside its payload, where a stray 0xB5 0x62 pair would look
      // like a frame header.
      for (size_t i = 0; i < (size_t)payloadLen + 2; i++) {
        while (!gnssSerial.available() && (int32_t)(millis() - deadline) < 0) {
          delay(1);
        }
        if (!gnssSerial.available()) {
          return false; // timed out mid-frame
        }
        gnssSerial.read();
      }
      continue;
    }

    out[0] = 0xB5;
    out[1] = 0x62;
    memcpy(out + 2, header, 4);

    for (size_t i = 0; i < (size_t)payloadLen + 2; i++) {
      while (!gnssSerial.available() && (int32_t)(millis() - deadline) < 0) {
        delay(1);
      }
      if (!gnssSerial.available()) {
        return false; // timed out mid-frame
      }
      out[6 + i] = gnssSerial.read();
    }

    // Verify the checksum over class..payload before trusting the frame.
    uint8_t ckA = 0;
    uint8_t ckB = 0;
    for (size_t i = 2; i < 6 + (size_t)payloadLen; i++) {
      ckA = (uint8_t)(ckA + out[i]);
      ckB = (uint8_t)(ckB + ckA);
    }
    if (ckA != out[6 + payloadLen] || ckB != out[7 + payloadLen]) {
      continue; // corrupt; keep scanning
    }

    if (header[0] == cls && header[1] == id) {
      *outLen = frameLen;
      return true;
    }
  }

  return false;
}

// Wait for UBX-ACK-ACK acknowledging the given class/id.
static bool waitForAck(uint8_t cls, uint8_t id, uint32_t timeoutMs) {
  uint8_t frame[16];
  size_t frameLen = 0;
  uint32_t deadline = millis() + timeoutMs;

  while ((int32_t)(millis() - deadline) < 0) {
    uint32_t remaining = (uint32_t)(deadline - millis());
    if (!waitForUbxFrame(0x05, 0x01, frame, sizeof(frame), &frameLen,
                         remaining)) {
      return false;
    }
    if (frameLen == 10 && frame[6] == cls && frame[7] == id) {
      return true;
    }
    // An ACK for something else - keep waiting.
  }
  return false;
}

static void printHex(const uint8_t *buf, size_t len) {
  for (size_t i = 0; i < len; i++) {
    Serial.printf("%02X", buf[i]);
    if (i + 1 < len) {
      Serial.print(' ');
    }
    if ((i + 1) % 16 == 0 && i + 1 < len) {
      Serial.print("\n    ");
    }
  }
  Serial.println();
}

// --- Connection ------------------------------------------------------------
static bool connectAtAnyBaud() {
  for (int i = 0; i < NUM_BAUD_RATES; i++) {
    uint32_t baud = BAUD_RATES[i];
    Serial.printf("  trying %lu baud...\n", (unsigned long)baud);

    GNSS_SERIAL_PREPARE();
    GNSS_SERIAL_BEGIN(baud);
    delay(100);

    if (myGNSS.begin(gnssSerial)) {
      Serial.printf("  connected at %lu baud.\n", (unsigned long)baud);
      return true;
    }

    gnssSerial.end();
    delay(100);
  }
  return false;
}

// --- Quieting the receiver -------------------------------------------------
// Periodic output is the only thing that can fill the UART buffer while this
// sketch isn't draining it, and there is exactly one such window: the blocking
// wait for the operator to type the confirmation word, which lasts as long as
// they take. Everything else here either reads continuously or has the port
// closed. Silencing the stream removes that window, and it also means the ACK
// and VALGET replies land in an otherwise empty stream, so the frame scanner
// has nothing to resync through.
//
// UBX output protocol must stay ON: ACK-ACK and the VALGET reply are UBX, so
// turning CFG-UART1OUTPROT-UBX off would silence the very frames this sketch
// waits for. What gets turned off is NMEA, plus the periodic NAV messages -
// none of which is a poll response.
//
// Dropping CFG-RATE-MEAS to 1 Hz is the catch-all: any periodic message not in
// the list below still gets 20x quieter on a receiver configured the way Gnimu
// configures one.
//
// All of it is written to the RAM layer, so a power cycle restores the
// receiver, the CFG-RST at the end of a successful burn does the same, and
// the Gnimu firmware checks and restores every setting from Config.h at boot
// regardless. Nothing here needs undoing.
static const uint32_t PERIODIC_NAV_MSGS[] = {
    UBLOX_CFG_MSGOUT_UBX_NAV_PVT_UART1,
    UBLOX_CFG_MSGOUT_UBX_NAV_SAT_UART1,
    UBLOX_CFG_MSGOUT_UBX_NAV_SIG_UART1,
    UBLOX_CFG_MSGOUT_UBX_NAV_STATUS_UART1,
    UBLOX_CFG_MSGOUT_UBX_NAV_DOP_UART1,
    UBLOX_CFG_MSGOUT_UBX_NAV_POSLLH_UART1,
    UBLOX_CFG_MSGOUT_UBX_NAV_TIMEGPS_UART1};
static const int NUM_PERIODIC_NAV_MSGS =
    sizeof(PERIODIC_NAV_MSGS) / sizeof(PERIODIC_NAV_MSGS[0]);

// Counts bytes arriving over windowMs without parsing them.
static uint32_t countIncomingBytes(uint32_t windowMs) {
  uint32_t count = 0;
  uint32_t deadline = millis() + windowMs;
  while ((int32_t)(millis() - deadline) < 0) {
    while (gnssSerial.available()) {
      gnssSerial.read();
      count++;
    }
    delay(1);
  }
  return count;
}

static void quietReceiver() {
  Serial.println("--- Quieting periodic output (RAM layer) ---");

  uint32_t before = countIncomingBytes(500);
  Serial.printf("  before: %lu bytes in 500 ms\n", (unsigned long)before);

  // NMEA off, UBX kept - the replies this sketch waits for are UBX.
  if (!myGNSS.setUART1Output(COM_TYPE_UBX, VAL_LAYER_RAM)) {
    Serial.println("  WARNING: could not disable NMEA output.");
  }

  int silenced = 0;
  for (int i = 0; i < NUM_PERIODIC_NAV_MSGS; i++) {
    if (myGNSS.setVal8(PERIODIC_NAV_MSGS[i], 0, VAL_LAYER_RAM)) {
      silenced++;
    }
  }
  Serial.printf("  periodic NAV messages set to 0: %d of %d\n", silenced,
                NUM_PERIODIC_NAV_MSGS);

  if (!myGNSS.setVal16(UBLOX_CFG_RATE_MEAS, 1000, VAL_LAYER_RAM)) {
    Serial.println("  WARNING: could not drop the measurement rate to 1 Hz.");
  }

  delay(200);
  drainSerial();

  uint32_t after = countIncomingBytes(500);
  Serial.printf("  after:  %lu bytes in 500 ms\n", (unsigned long)after);

  if (after > 200) {
    Serial.println("  Still chattier than expected. Not fatal - the frame");
    Serial.println("  scanner below copes with interleaved traffic - but the");
    Serial.println("  buffer has less slack during the confirmation wait.");
  }

  Serial.println();
}

// --- Identity --------------------------------------------------------------
// Returns true if this looks like M10 silicon. The burn is only offered on a
// part the manual's procedure is actually written for.
static bool printIdentity() {
  Serial.println("--- Identity (UBX-MON-VER) ---");

  if (!myGNSS.getModuleInfo()) {
    Serial.println("  getModuleInfo() FAILED - cannot identify the receiver.");
    Serial.println();
    return false;
  }

  const char *type = myGNSS.getFirmwareType();
  uint8_t protHigh = myGNSS.getProtocolVersionHigh();
  uint8_t protLow = myGNSS.getProtocolVersionLow();

  Serial.printf("  firmware : %s %u.%02u\n",
                (type != nullptr && type[0] != '\0') ? type : "(empty)",
                myGNSS.getFirmwareVersionHigh(),
                myGNSS.getFirmwareVersionLow());
  Serial.printf("  protver  : %u.%02u\n", protHigh, protLow);

  // PROTVER 34.x is the u-blox M10 generation. 34.10 is ROM SPG 5.10, which is
  // what the affected-products list in information note UBX-23006557 covers.
  bool looksLikeM10 = (protHigh == 34);
  if (!looksLikeM10) {
    Serial.println(
        "  This is not PROTVER 34.x, so it is not the M10 generation");
    Serial.println(
        "  this procedure is written for. No write will be offered.");
  } else if (protLow != 10) {
    Serial.println("  NOTE: PROTVER 34.10 (ROM SPG 5.10) is the firmware the");
    Serial.println(
        "  manual documents this procedure against. Yours differs -");
    Serial.println("  check your own product's integration manual first.");
  }

  Serial.println();
  return looksLikeM10;
}
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
