c20d-us/Gnimu/(commit log)

2026-07-23 Simplify battery SoC curve
2026-07-24 Calibration updates
2026-08-27 Enable charge-only on USB
2026-08-30 Re-enable charge only on USB
2026-08-31 Adjust BLE power
2026-09-09 IMU active calibration
2026-09-17 Update BLE power
2026-09-18 ESP32 reliability fixes
2026-09-24 Battery tweaks
2026-10-09 imu driver minification
2026-10-09 fix IMU fault at startup
2026-10-10 Restore IMU trim design doc for Classic
2026-10-10 Bring GNSS tools in line with current conventions; drop gnss_ver phase 6
2026-10-10 Move GNSS baud to system constants; rename NG wiring to V2
2026-10-10 Add board build guides and Classic migration guide
2026-10-10 Sample the battery once a second instead of four times
2026-10-10 Default the XIAO's IMU axes to the current build's orientation
2026-10-11 Add top-level images for the current guides, with carrier PCB photos
2026-10-18 PCB build description
2026-10-18 update pcb build doc
