c20d-us/Gnimu/(notices)

Notices in the files:
src/tools/nRF52840/gnss_pmreq/gnss_pmreq.ino:
This program is free software: you can redistribute it and/or modify
it under the terms of the GNU General Public License as published by
the Free Software Foundation, either version 3 of the License, or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
